R-Studios/Rocky-Hockey-IV/VortragsMedien/Images/ImageDebuggingWindow/MedianBlur.png

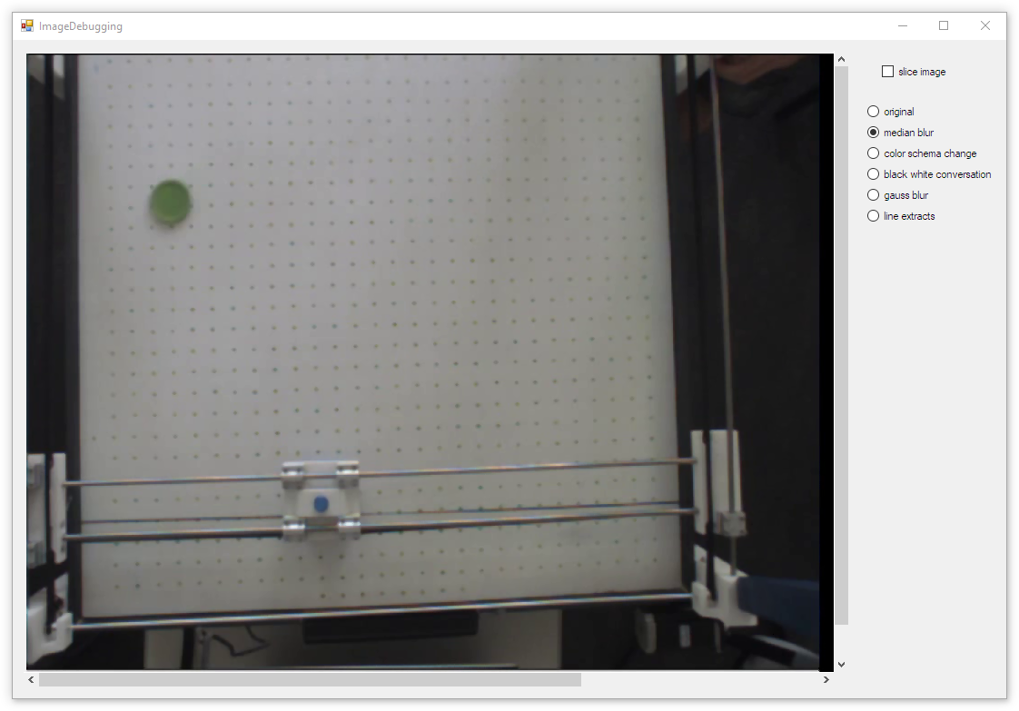
VortragsMedien/Images/ImageDebuggingWindow/MedianBlur.png
