R-Studios/Rocky-Hockey-IV/VortragsMedien/Images/ImageDebuggingWindow/ChangedColorSchema.png

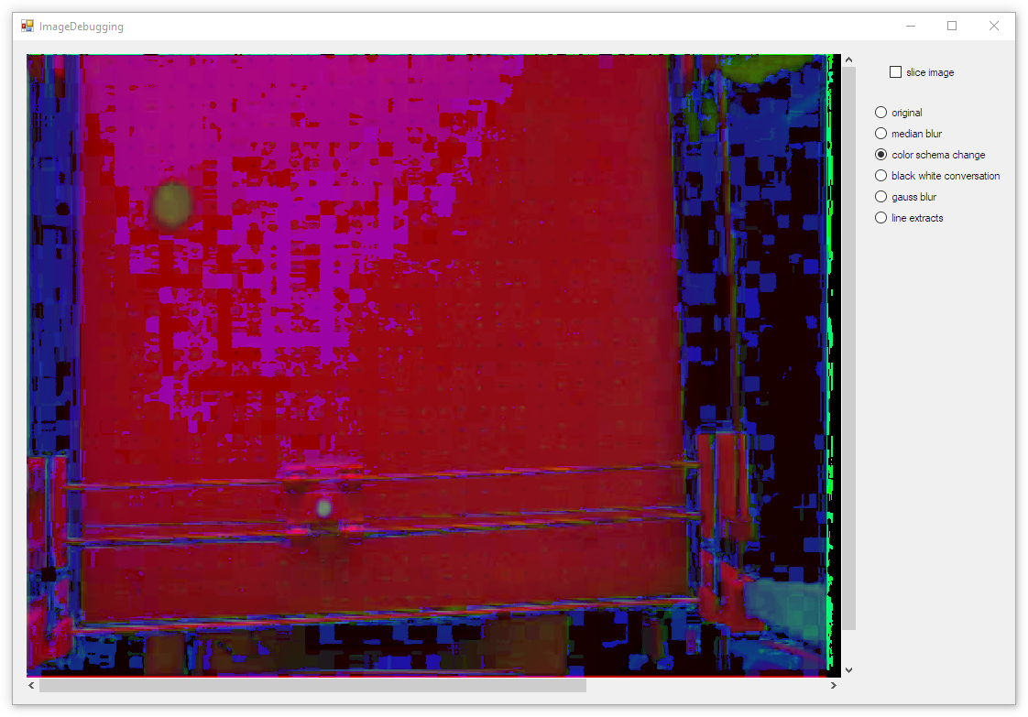
VortragsMedien/Images/ImageDebuggingWindow/ChangedColorSchema.png
