R-Studios/Rocky-Hockey-IV/Berichte/Rocky Hockey IV Bericht 12.pdf

# Rocky Hockey IV

Bericht über Woche 12
Zeitraum: 8.06.2020 – 14.06.2020 Teamleiter: Thomas Brücklmayr Berichterstatter: Thomas Brücklmayr

Rückblick auf die letzte Woche:
Thomas G. hat die Zwischenplatte überarbeitet, erneuter Funktionstest steht noch an. 12.06.: André holt die Materiallieferung ab und deponiert diese im Raum. Alex überprüft das Material anschließend noch.

Wegen Seminararbeiten diverser Gruppenmitglieder hat sich anderweitig kein Fortschritt ergeben.

Ausblick auf die nächste Woche:
Arbeit am digitalen Tisch starten. Neue Hardware einbauen.
