R-Studios/Rocky-Hockey-IV/Berichte/Rocky Hockey IV Bericht 15.pdf

# Rocky Hockey IV

Bericht über Woche 15
Zeitraum: 28.06.2020 – 03.07.2020 Teamleiter: Thomas Brücklmayr Berichterstatter: Alexander Fichtl

Rückblick auf die letzte Woche:
Thomas B., Alexander, Roman, David, Marco, und Domi trafen sich am Dienstag den 30.06. und führten einen Integrationstest der neuen Kameramodule durch. Leider traten durchgehend Fehler auf, für die es keine Dokumentation von ArduCam gibt. Nach einigen Stunden hatten wir aber endlich ein Bild in einem Visual Studio Projekt auf Romans Rechner. Uns wurde jedoch klar, dass wir durch die sehr späte Lieferung der Kamera Module voraussichtlich die Integration bis zur Projektvorstellung nicht abschließen können. Daher arbeiten wir nun parallel wieder mit der PS3 Kamera. Thomas B. hat dabei jeweils ein Fenster erstellt, welches die Verarbeitungsstufen des Eingangsbildes darstellen kann und eines, mit welchem sich die Entzerrung des Bildes einstellen lässt.
Ein zweites Treffen von Thomas B., Alexander, und Roman gab es am Donnerstag den 02.07.. Es wurde erneut versucht die neue Kamera zu integrieren, was jedoch wieder scheiterte. Wir entschieden uns noch auf zusätzlichen Wegen mit dem Support Team Kontakt aufzunehmen, wobei wir jedoch bis heute weiterhin keine Antwort erhalten haben. Da wir nun Bescheid kamen, dass bereits am 07.07. die Präsentation des Projektes ansteht, fokussierten wir uns auf die Arbeit mit der alten Kamera. Thomas B. hat dabei ein weiteres Fenster erstellt, mit welchen man die Parameter für die Puckerkennung einstellen kann. Dafür wurde auch die Bildverarbeitungsklasse überarbeitet und eine Klasse erstellt, mit der man von einem Video aus Bilder einlesen kann (so muss man den Code nicht immer im Raum testen, sondern auch von zuhause aus). Des Weiteren erstellte Alexander ein Layout für den Abschlussbericht und setzte diesen auf.
Das gesamte Team traf sich dann am Freitag den 03.07. (auch im Projektraum) und besprach das Vorgehen bei der anstehenden Präsentation und Poster Session. Es wurden Videos aufgenommen, die zusammengeschnitten auf Zoom gezeigt werden sollen.

Ausblick auf die nächste Woche:
Bis Dienstag muss das Video für die Präsentation geschnitten und die Poster Session vorbereitet werden.
Der Abschlussbericht muss geschrieben werden, so dass dieser in der folgenden, letzten Woche finalisiert werden kann. Alexander wird dies koordinieren.
Es gibt noch einige Baustellen im Code, die bearbeitet werden müssen.
Sollten wir endliche eine Antwort des ArduCam Supports erhalten, können wir eventuell auch noch weiter mit der neuen Kamera arbeiten.
