R-Studios/Rocky-Hockey-IV/Berichte/Rocky Hockey IV Bericht 16.docx

Rocky Hockey IV

Bericht über Woche 16

Zeitraum: 04.07.2020 – 10.07.2020

Teamleiter: Thomas Brücklmayr

Berichterstatter: Alexander Fichtl

Rückblick auf die letzte Woche:

Es wurde entschieden, dass Thomas B., Alexander, Roman und Andre gemeinsam die Projekt Präsentation und Poster Sessions halten. Thomas B. und Roman kümmerten sich über das Wochenende hinweg um das Erstellen der Präsentation und einer Slide Show für die Poster Session.

Beides wurde am Montag bei zwei Test Zoom Sessions von Thomas B., Alexander und Roman finalisiert, leider gab es einen Hardwarefehler bei einem der Schrittmotoren, weshalb eine live Demo kurz vor knapp aus dem Plan gestrichen werden musste. Zum Glück gab es aber Aufnahmen von dem funktionierenden Tisch, welche wir in die Präsentation einfügen konnten. Andre hat außerdem noch ein Problem mit der Score-Zählung an der Java GUI gefixt.

Am Dienstag traf sich das selbige Präsentationsteam um 13:30 Uhr im Raum und bereitete die offiziellen Zoom Sessions vor. Außerdem montierten Sie das neue, von Sarah gebaute Gerüst und befestigten die Kamera. Anschließend hielten sie die Präsentation. Zur Poster Session konnten sie die Slide Show über Zoom übertragen und per WebCam den AirHockey Tisch vorstellen.

Über die Woche hinweg haben bereits einige Teammitglieder ihren Abschlussbericht Teil fertiggestellt.

Ausblick auf die nächste Woche:

Hier und da wird noch am Code gebastelt werden.

Der Bericht muss fertiggestellt werden. Dazu braucht es die Teile der übrigen Teammitglieder. Alexander wird anschließend das Layout korrigieren und nochmals anpassen.
