R-Studios/Rocky-Hockey-IV/Berichte/Rocky Hockey IV Bericht 13.pdf

### Rocky Hockey IV

Bericht über Woche 13

Zeitraum: 15.06.2020 – 21.06.2020

Teamleiter: Thomas Brücklmayr

Berichterstatter: Sarah Hörmann

Rückblick auf die letzte Woche:

David, Marco und Thomas B. haben sich mit der Strategie beschäftigt. Sie haben festgelegt, welche Klassen benötigt werden, um die Strategie zu berechnen. Außerdem haben sie ein Interface erstellt, damit die von David und Marco erstellten Klassen miteinander kommunizieren können.

Dominik hat die Steuerung und Oberfläche vom virtuellen Tisch erstellt. Die Simulation mit dem Puck funktioniert. Allerdings werden die Daten des Schlägers noch nicht analysiert und ausgewertet.

Thomas G. hat die Zwischenplatte vom Tisch angepasst, aber noch nicht angebracht.

Andre hat das System zum Hochheben der Platte angebracht und dabei noch kleinere Veränderungen vorgenommen.

Alex hat die neue Hardware erstmals angeschlossen und mit dessen Integration begonnen.

Ausblick auf nächste Woche:

Dominik wird die Bewegungsdaten des Schlägers vom virtuellen Tisch analysieren und verarbeiten.

Erster Versuch alle Module in Betrieb zu nehmen.
