R-Studios/Rocky-Hockey-IV/Berichte/Rocky Hockey IV Bericht 2.pdf

Rockey Hockey IV

Bericht über Woche 11

Zeitraum: 01.06.2020 - 07.06.2020

Teamleiter: Thomas Brücklmayr

Berichterstatter: André Fischer

Rückblick auf die letzte Woche:

Am Donnerstag war André am Tisch und hat einen Prototypen seines Systems angebracht, sodass man die Platte inzwischen alleine hochheben und wieder runterlassen kann um Tests zu vereinfachen. Das Eigentliche System wird eingebaut, nachdem die neue Platte fertig ist und von dieser die Masse genommen werden konnten.

Dabei wurde entschieden, dass Thomas sich um die Pfadvorhersage für den Puck kümmert, während david marco n beiden an den Strategien arbeiten. Momentan können noch nur per Code die Puckbewegungen simuliert werden

Ausblick auf die nächste Woche:

An einer Live-Vorschau der Kamera als richtiges Feature und einem virtuellen Tisch, an dem auch ohne den Tischaufbau getestet werden kann arbeiten Roman und Dominik. David und Marco implementieren die neuen Spielstrategien. Sarah beginnt mit dem Neubau der Halterung für die Kamera. Meiko startet damit, die Dokumentation zu schreiben.
