R-Studios/Rocky-Hockey-IV/Berichte/Rocky Hockey IV Bericht 11.pdf

# Rocky Hockey IV

Bericht über Woche 11

Zeitraum: 01.06.2020 – 07.06.2020

Teamleiter: Thomas Brücklmayr

Berichterstatter: Thomas Gantner

Rückblick auf die letzte Woche:

Dominik und Roman haben in der C# GUI die Fenster überarbeitet und haben eine Live Ansicht der aktuellen Kamera hinzugefügt. Sie zeigt später die Sicht der Kamera die oben am Tisch befestigt ist an.

Marco hat sich mit der Strategie beschäftigt, dort hat er festgestellt, dass die Strategie Bande bereits implementiert ist, ebenso hat er sich damit beschäftigt was passiert, wenn der Puck stehen bleibt.

André hat einen Prototyp angebracht, um die Platte hochzuheben. Jedoch war noch nicht sicher, ob wir eine neue Tischplatte bauen oder die alte weiterverwenden.

Meiko hat angefangen, die Dokumentation zu schreiben.

Sarah hat mit der Haltung für die Kamera angefangen, da die Kamera aber noch nicht da ist, hat sie noch nicht die Höhe der Kamera festgelegt.

Thomas G. hat die zwischenplatte angebracht, jedoch konnte hier noch keine Verbesserung des Luftstroms erzielt werden.

Ausblick auf nächste Woche:

Dominik und Thomas B. arbeiten an der Testumgebung, um Strategien testen zu können. Da die bestellten Teile vermutlich angekommen sind, werden diese nächste Woche getestet.
