R-Studios/Rocky-Hockey-IV/Berichte/Rocky Hockey IV Bericht 9.pdf

# Rocky Hockey IV

Bericht über Woche 9
Zeitraum: 18.04.2020 – 24.04.2020 Teamleiter: Thomas Brücklmayr Berichterstatter: Thomas Brücklmayr

Rückblick auf die letzte Woche:
22.05.: Sarah uns Meiko waren in der Hochschule und haben Maße vom Tisch genommen um das Kameragestell verbessern zu können. Meiko hat angefangen die Verkabelung des Tisches zu überarbeiten.

Sonstiges:
Die Zylinder für die Zwischenplatte sind angekommen und Thomas G. hat diese fertiggestellt, sie muss aber noch montiert werden.
Roman hat einen Ordner auf Github erstellt, in dem die Wochenberichte abgelegt werden sollen. André hat am Abschlussbericht weiter gearbeitet.
Bei der Strategieüberarbeitung und beim Testframework gibt es kein Update, da einige Mitglieder ihre Seminararbeiten halten mussten.

Ausblick auf die nächste Woche:
Arbeit an der Strategieüberarbeitung und dem Testframework starten.
