R-Studios/Rocky-Hockey-IV/Rockey_HockeyFotos_31.03.2020/00d87915-95fa-47ff-bbc2-8fb40d2df74e.jpg

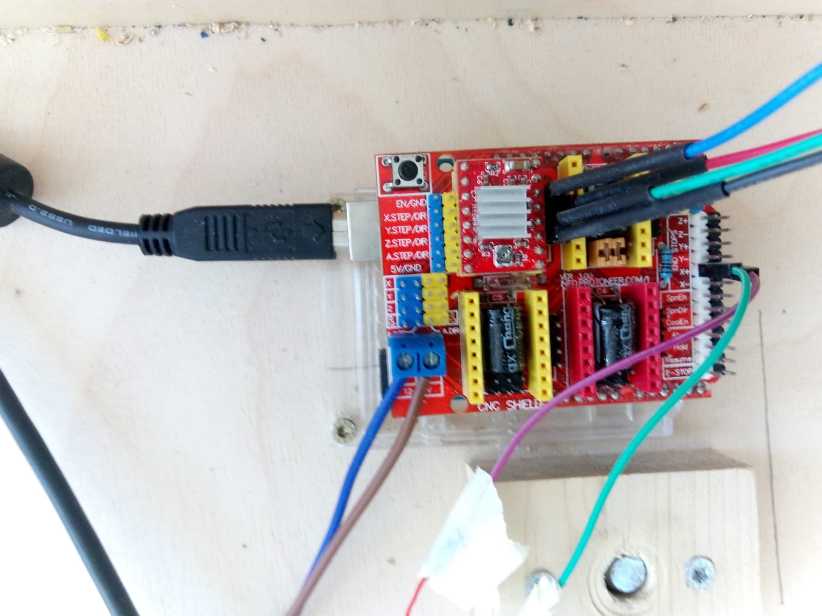
Rockey_HockeyFotos_31.03.2020/00d87915-95fa-47ff-bbc2-8fb40d2df74e.jpg
