R-Studios/Rocky-Hockey-IV/Rockey_HockeyFotos_31.03.2020/1ca494bc-8e8f-4f74-8567-929466d0e2ab.jpg

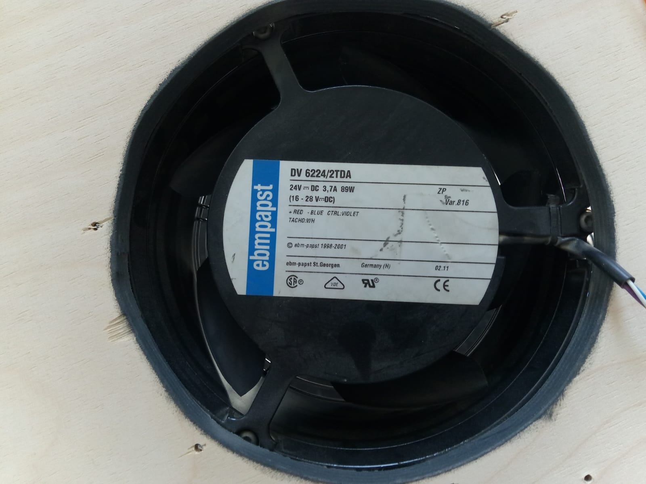
Rockey_HockeyFotos_31.03.2020/1ca494bc-8e8f-4f74-8567-929466d0e2ab.jpg
