R-Studios/Rocky-Hockey-IV/Rockey_HockeyFotos_31.03.2020/2cf4339c-4cba-40d5-88b1-021bc957ed77.jpg

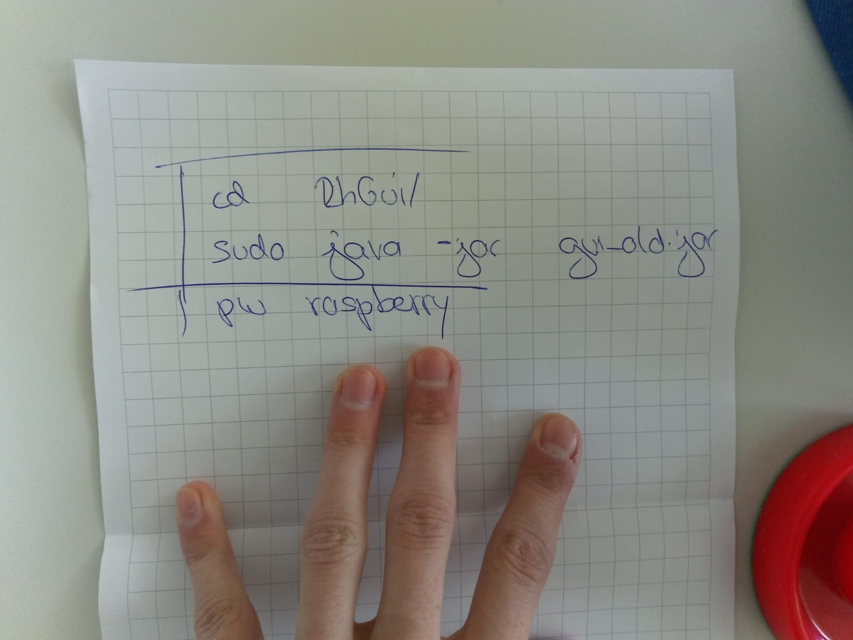
Rockey_HockeyFotos_31.03.2020/2cf4339c-4cba-40d5-88b1-021bc957ed77.jpg
