R-Studios/Rocky-Hockey-IV/Rockey_HockeyFotos_31.03.2020/03ef454f-9ccb-4f13-a578-67a4f2153c90.jpg

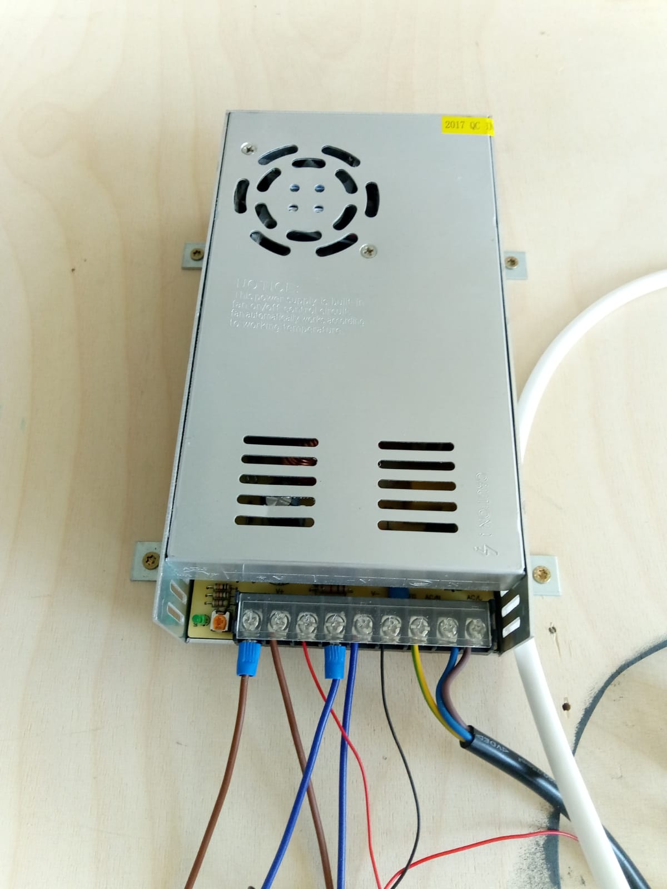
Rockey_HockeyFotos_31.03.2020/03ef454f-9ccb-4f13-a578-67a4f2153c90.jpg
