R-Studios/Rocky-Hockey-IV/Rockey_HockeyFotos_31.03.2020/5d71155f-a163-4400-9b1c-85306e660beb.jpg

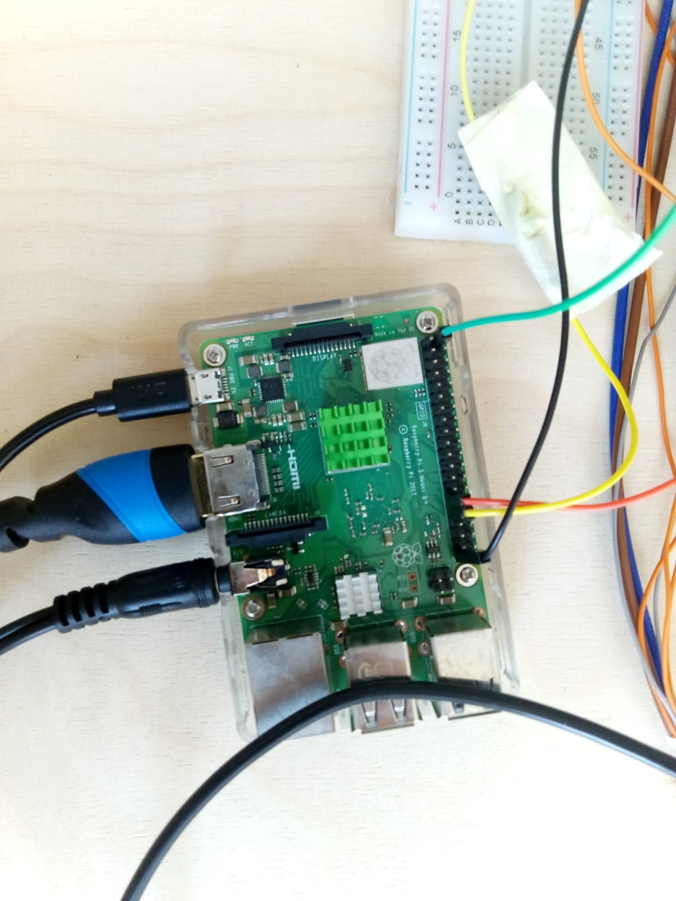
Rockey_HockeyFotos_31.03.2020/5d71155f-a163-4400-9b1c-85306e660beb.jpg
