R-Studios/Rocky-Hockey-IV/Rockey_HockeyFotos_31.03.2020/6ef581ab-93a6-46d1-a10a-12157c0630af.jpg

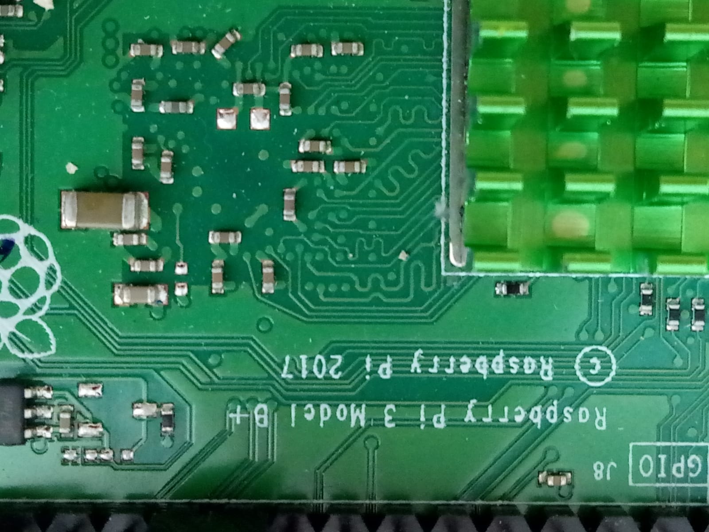
Rockey_HockeyFotos_31.03.2020/6ef581ab-93a6-46d1-a10a-12157c0630af.jpg
