R-Studios/Rocky-Hockey-IV/Rockey_HockeyFotos_31.03.2020/7f3fc055-a3bd-482a-82d1-738601f66e74.jpg

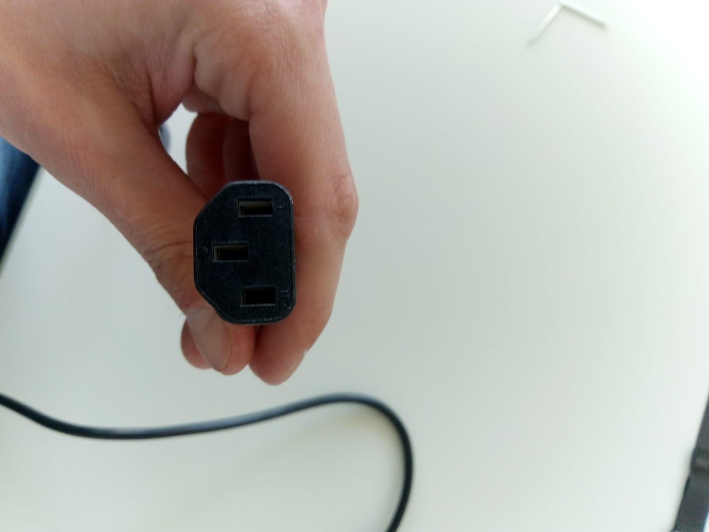
Rockey_HockeyFotos_31.03.2020/7f3fc055-a3bd-482a-82d1-738601f66e74.jpg
