R-Studios/Rocky-Hockey-IV/Rockey_HockeyFotos_31.03.2020/9b0b73de-4b14-485d-8741-7454e812c25b.jpg

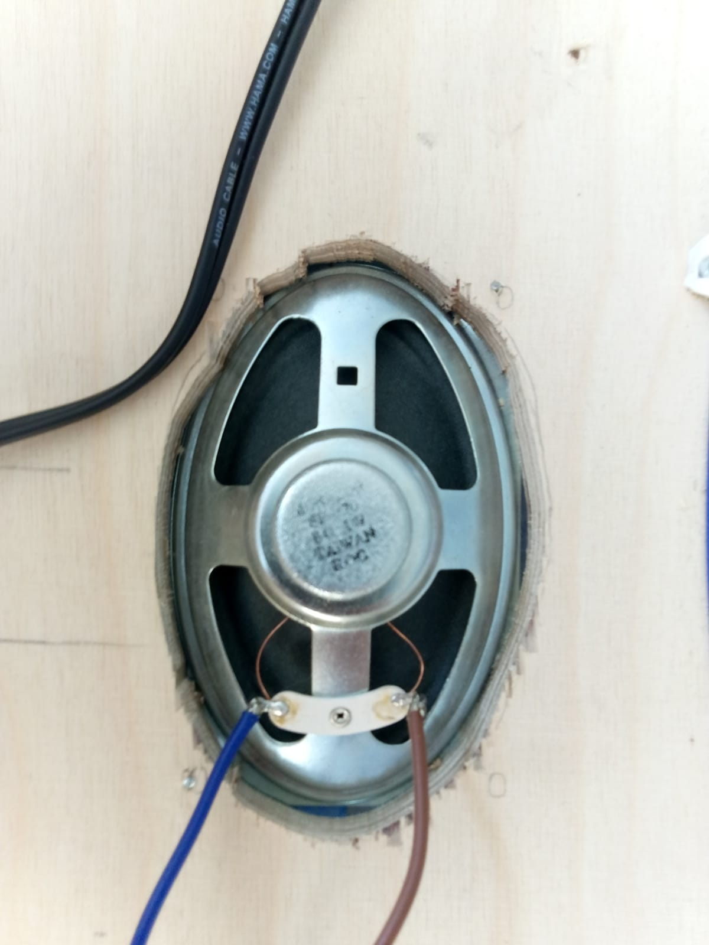
Rockey_HockeyFotos_31.03.2020/9b0b73de-4b14-485d-8741-7454e812c25b.jpg
