R-Studios/Rocky-Hockey-IV/Rockey_HockeyFotos_31.03.2020/21bee3ab-16a0-48f3-8c2e-569a640d96ab.jpg

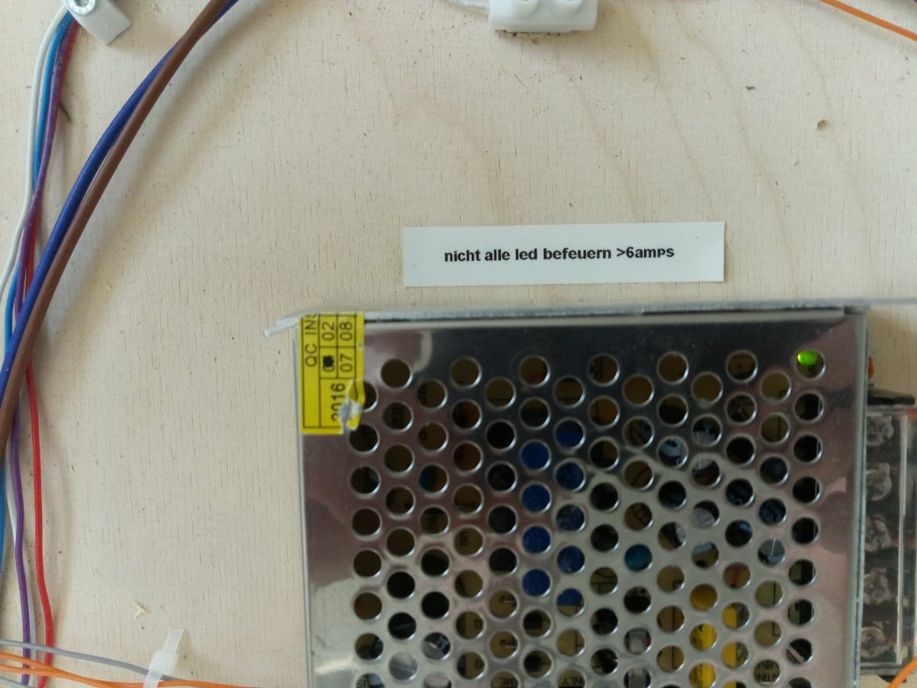
Rockey_HockeyFotos_31.03.2020/21bee3ab-16a0-48f3-8c2e-569a640d96ab.jpg
