R-Studios/Rocky-Hockey-IV/Rockey_HockeyFotos_31.03.2020/26e3dd24-239e-4486-86f7-c7c7a5132633.jpg

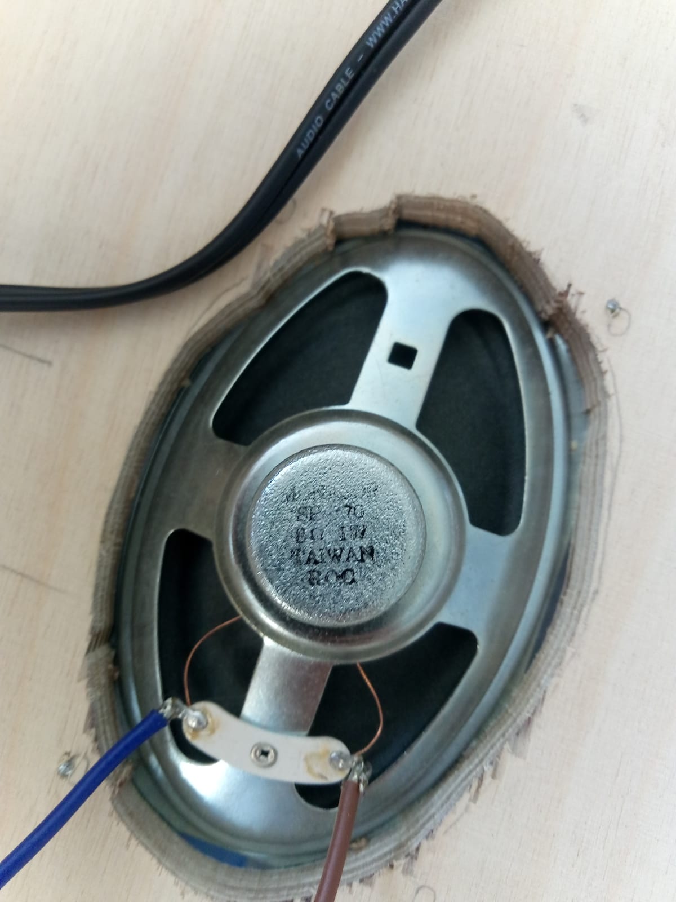
Rockey_HockeyFotos_31.03.2020/26e3dd24-239e-4486-86f7-c7c7a5132633.jpg
