R-Studios/Rocky-Hockey-IV/Rockey_HockeyFotos_31.03.2020/76b36d55-471f-48a3-a61c-02ed4cf30322.jpg

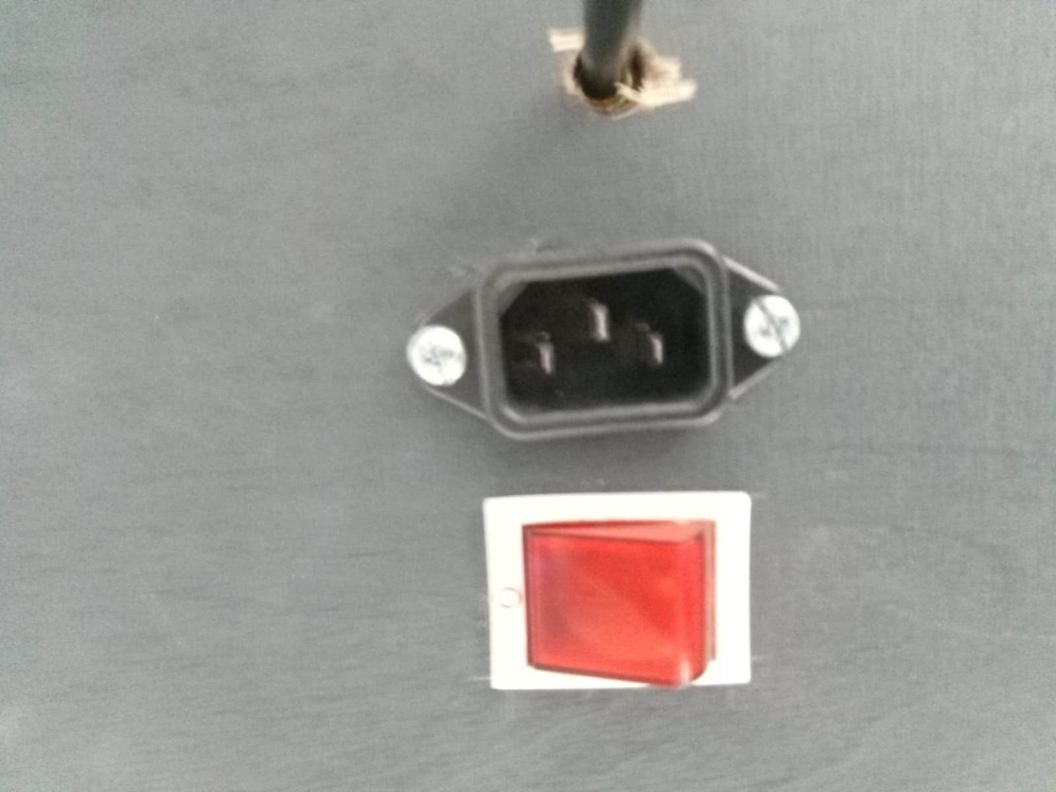
Rockey_HockeyFotos_31.03.2020/76b36d55-471f-48a3-a61c-02ed4cf30322.jpg
