R-Studios/Rocky-Hockey-IV/Rockey_HockeyFotos_31.03.2020/167ec176-c0d4-46ba-a58a-3f1380f40f1b.jpg

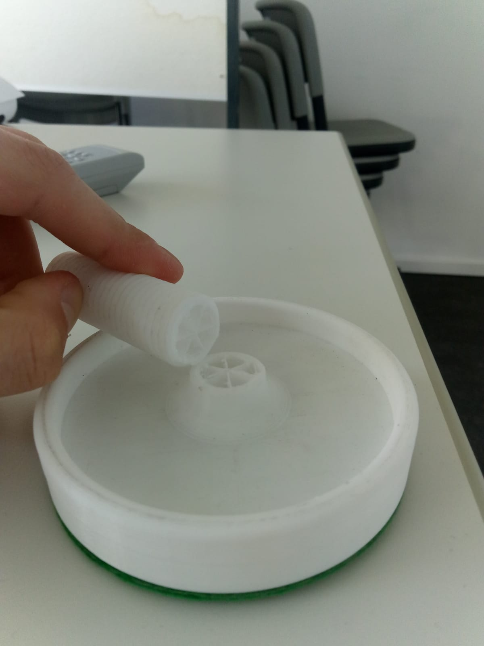
Rockey_HockeyFotos_31.03.2020/167ec176-c0d4-46ba-a58a-3f1380f40f1b.jpg
