R-Studios/Rocky-Hockey-IV/Rockey_HockeyFotos_31.03.2020/718ced31-0238-4f85-af24-9b75a0c0df73.jpg

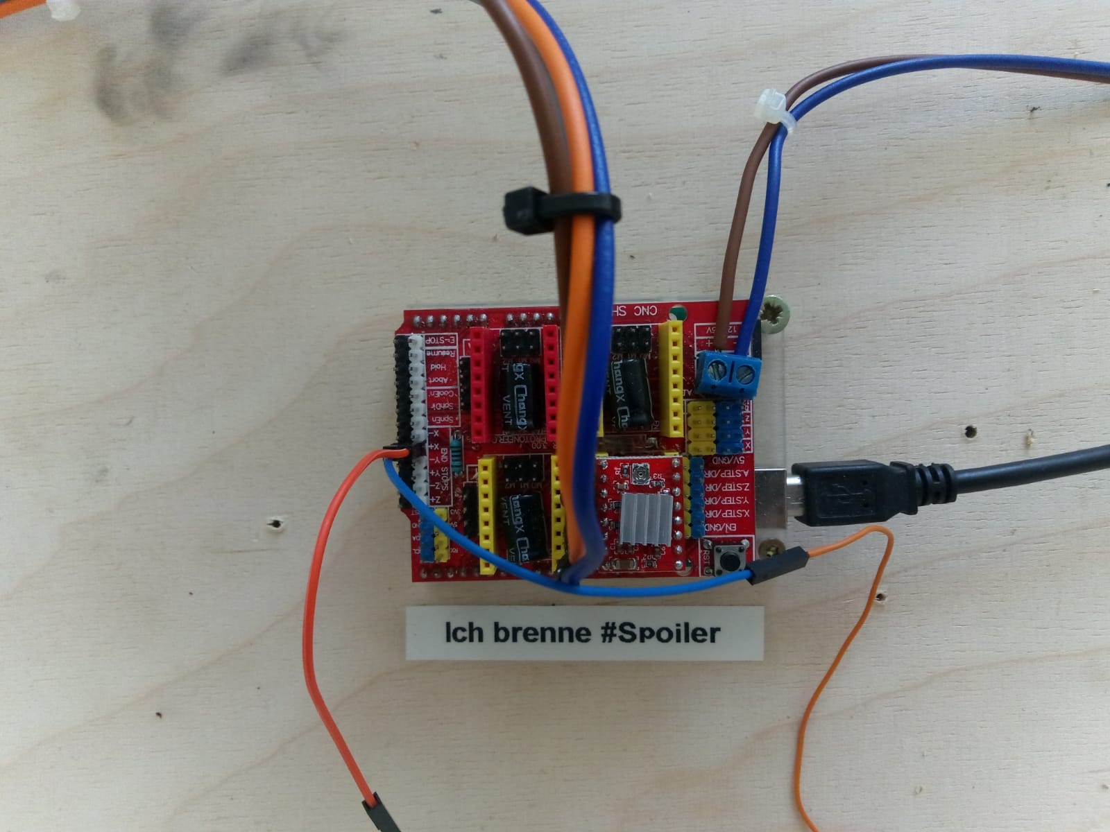
Rockey_HockeyFotos_31.03.2020/718ced31-0238-4f85-af24-9b75a0c0df73.jpg
