R-Studios/Rocky-Hockey-IV/Rockey_HockeyFotos_31.03.2020/73253075-4c92-4741-91b1-225926c06619.jpg

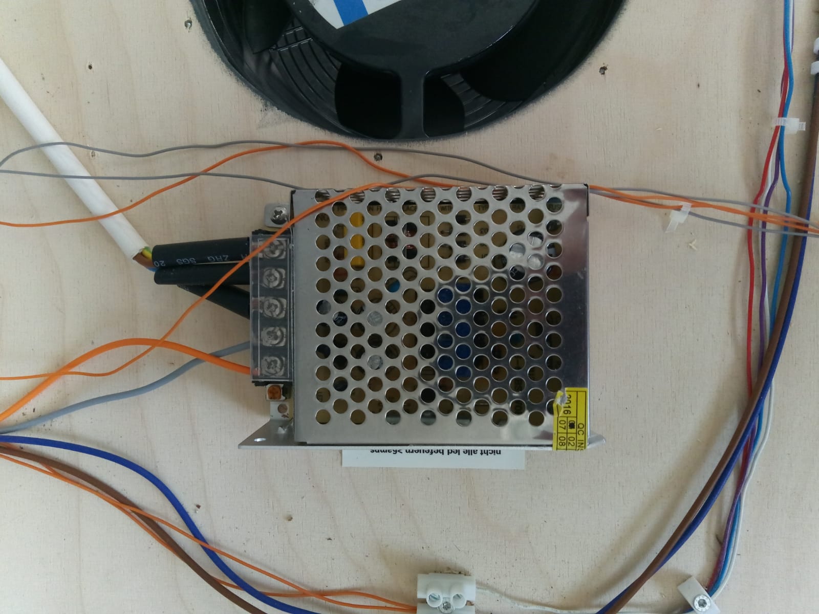
Rockey_HockeyFotos_31.03.2020/73253075-4c92-4741-91b1-225926c06619.jpg
