R-Studios/Rocky-Hockey-IV/Rockey_HockeyFotos_31.03.2020/a1b03794-e062-4586-b8a7-ea0471faf016.jpg

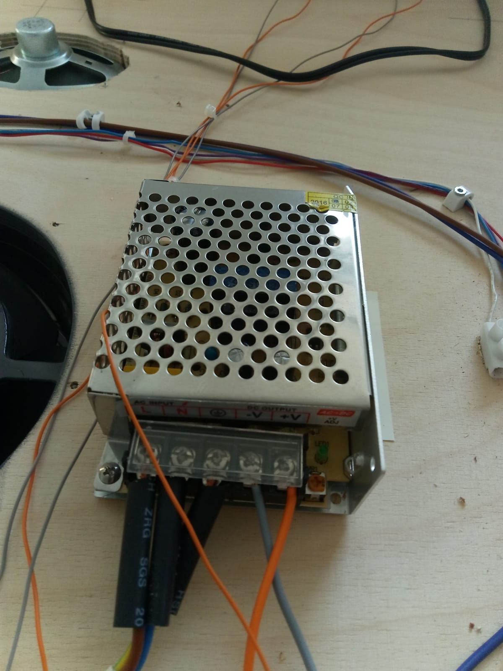
Rockey_HockeyFotos_31.03.2020/a1b03794-e062-4586-b8a7-ea0471faf016.jpg
