R-Studios/Rocky-Hockey-IV/Rockey_HockeyFotos_31.03.2020/cd410da4-7a8c-4a6b-875f-3e8eb30c133e.jpg

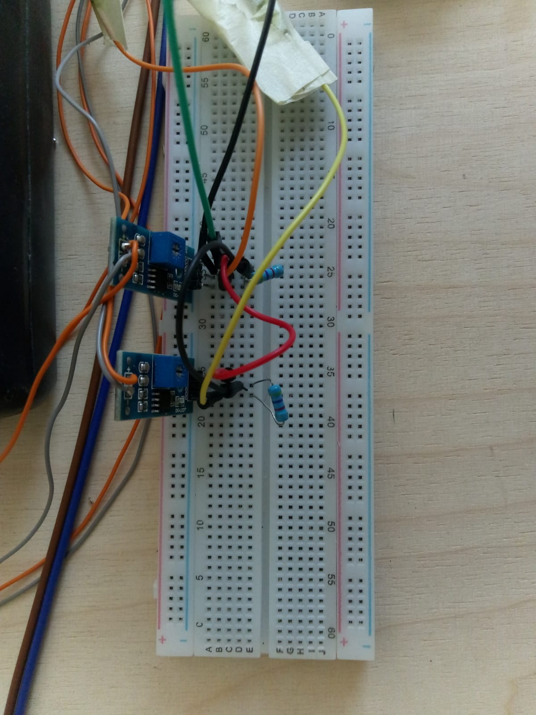
Rockey_HockeyFotos_31.03.2020/cd410da4-7a8c-4a6b-875f-3e8eb30c133e.jpg
