R-Studios/Rocky-Hockey-IV/Rockey_HockeyFotos_31.03.2020/eb7117b8-54d8-4a43-b824-05808e0c48bd.jpg

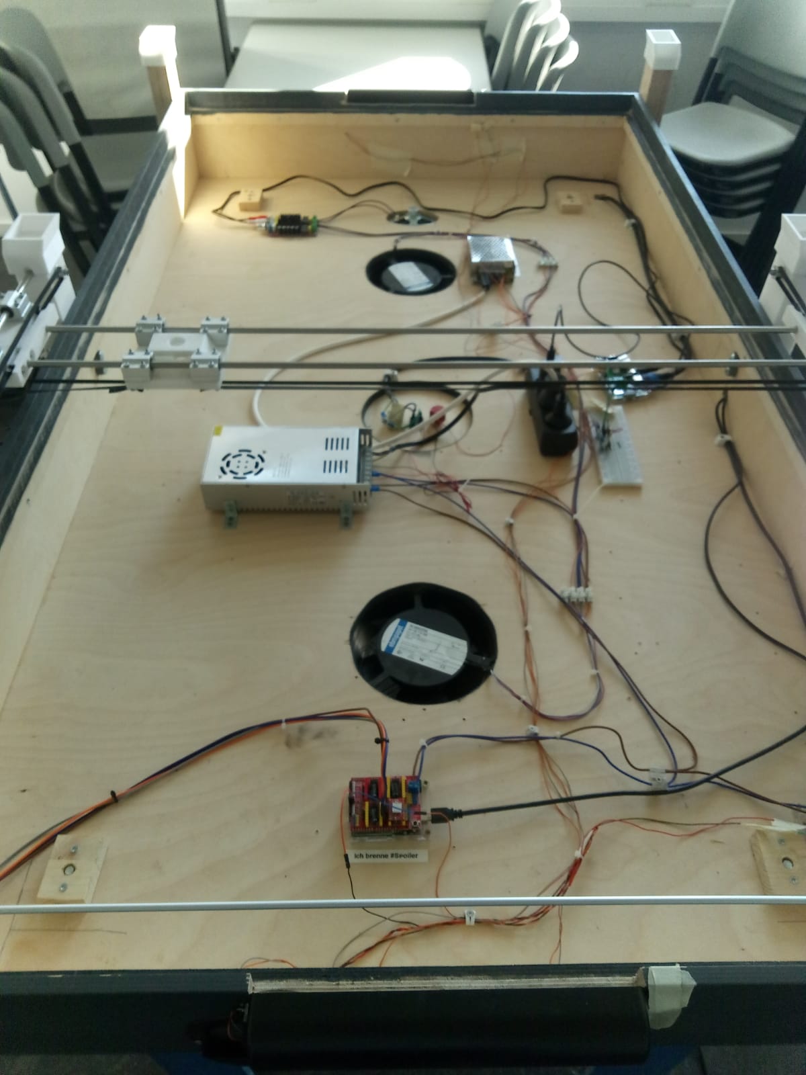
Rockey_HockeyFotos_31.03.2020/eb7117b8-54d8-4a43-b824-05808e0c48bd.jpg
