R-Studios/Rocky-Hockey-IV/Schaltplan/Schaltplan.jpg

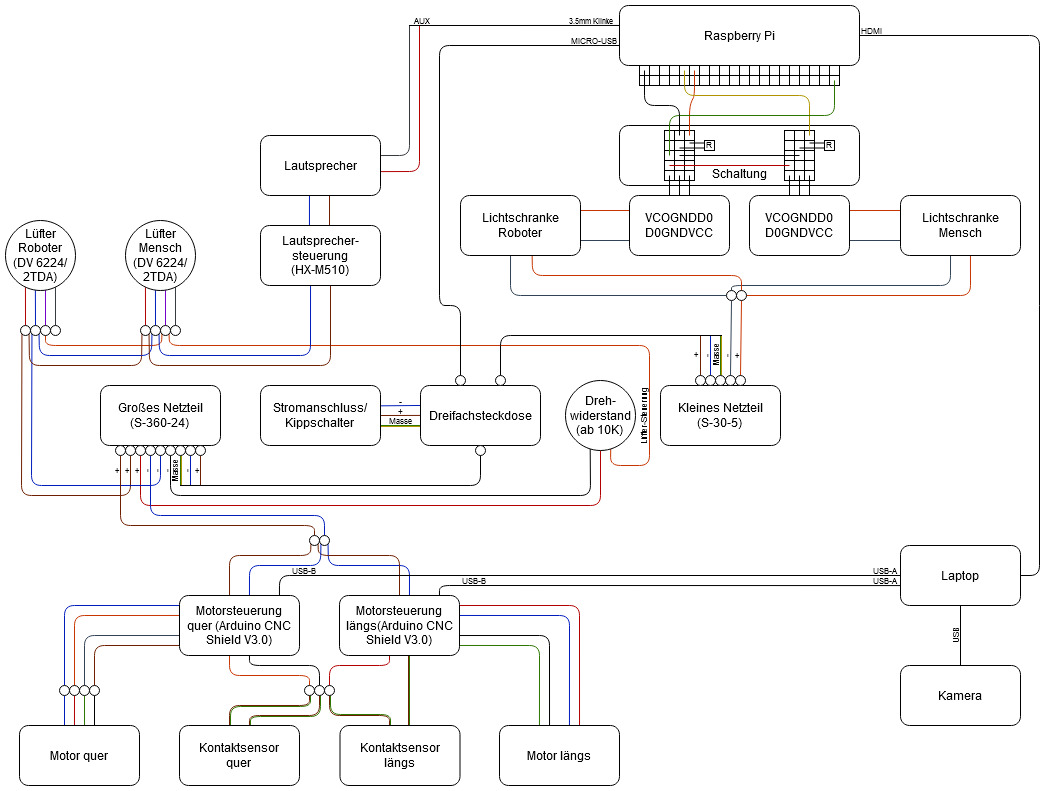
Schaltplan/Schaltplan.jpg
