R-Studios/Rocky-Hockey-IV/Schaltplan/Schaltplan_neu.jpg

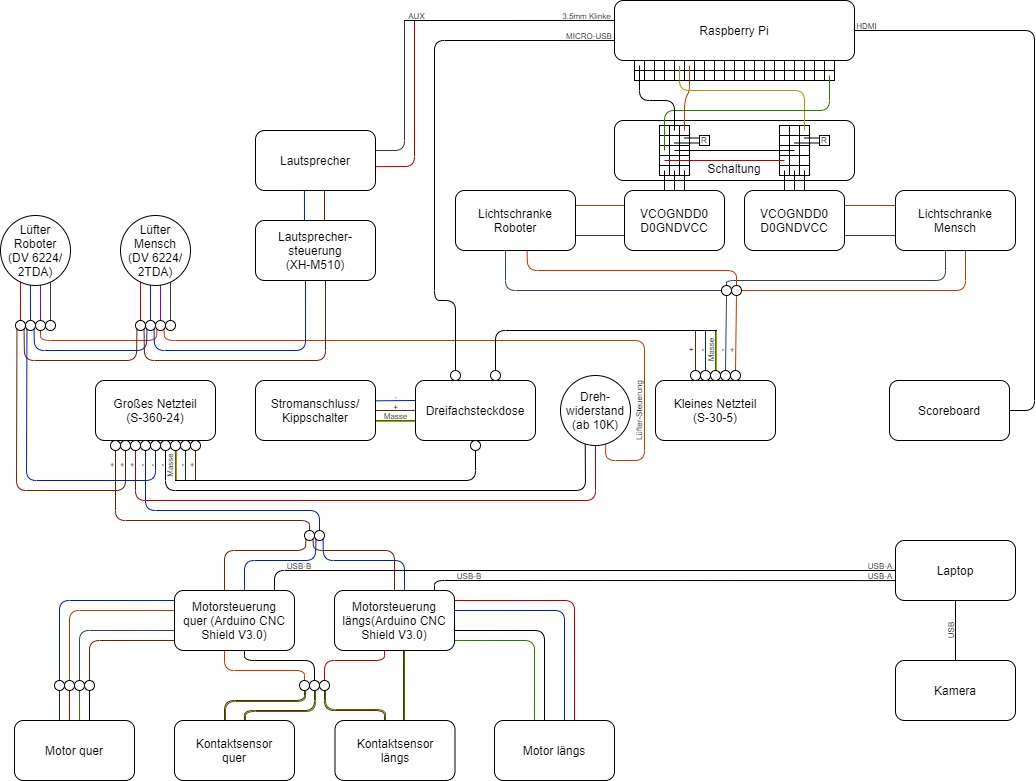
Schaltplan/Schaltplan_neu.jpg
