R-Studios/Rocky-Hockey-IV/STL Files/Überblick.PNG

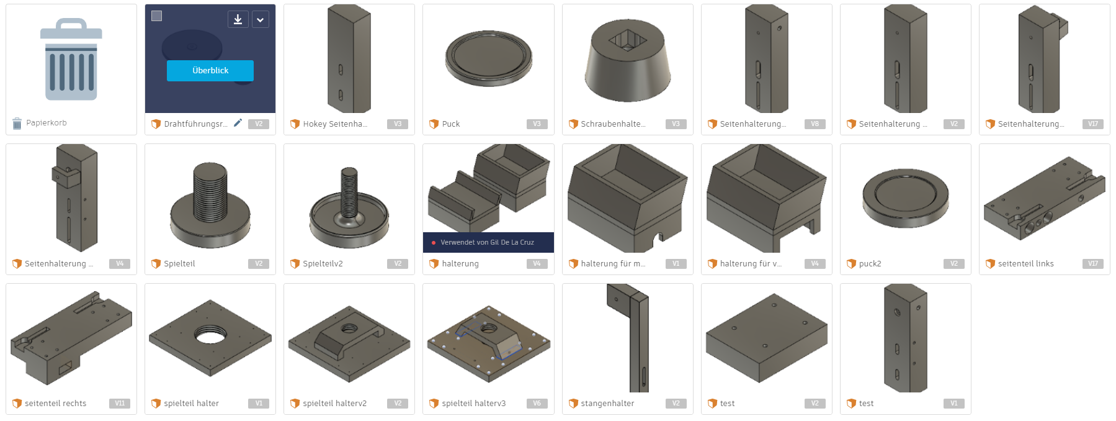
STL Files/Überblick.PNG
