R-Studios/Rocky-Hockey-IV/VortragsMedien/Images/CircleDetectionWindow/ImageAfterProcessing.png

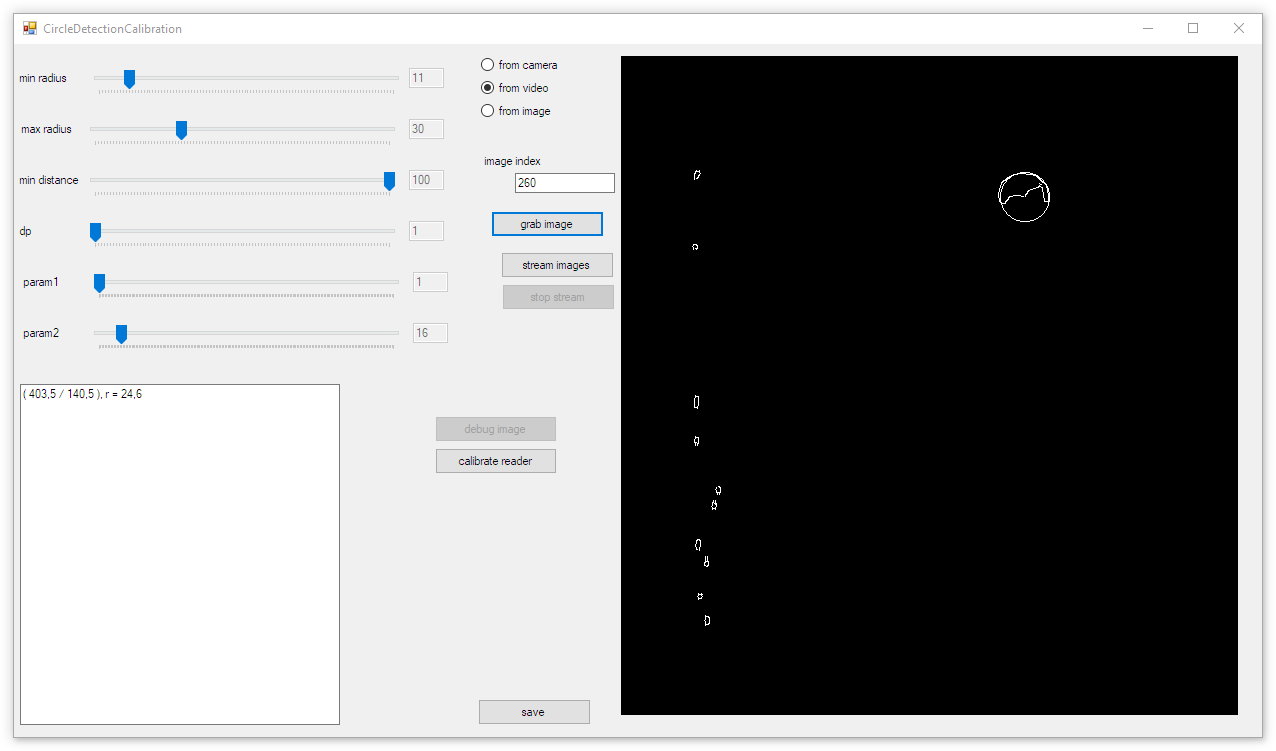
VortragsMedien/Images/CircleDetectionWindow/ImageAfterProcessing.png
