R-Studios/Rocky-Hockey-IV/VortragsMedien/Images/CircleDetectionWindow/OrignalImage.png

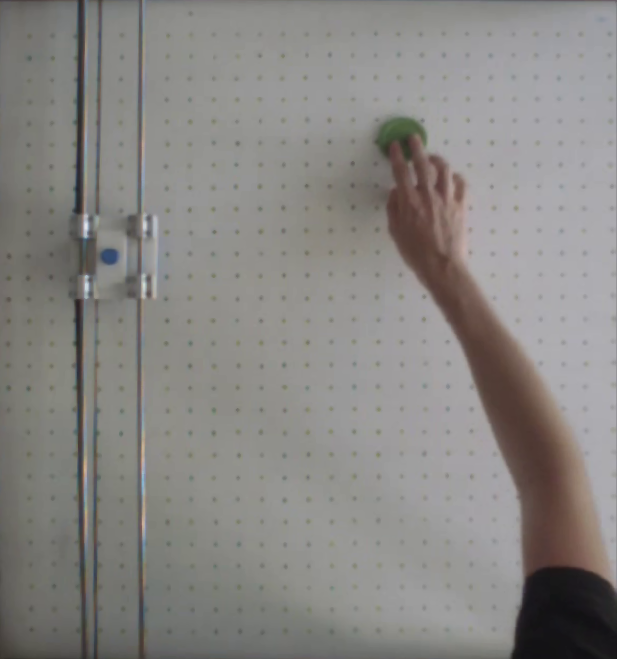
VortragsMedien/Images/CircleDetectionWindow/OrignalImage.png
