R-Studios/Rocky-Hockey-IV/VortragsMedien/Images/VirtualTable/Running.PNG

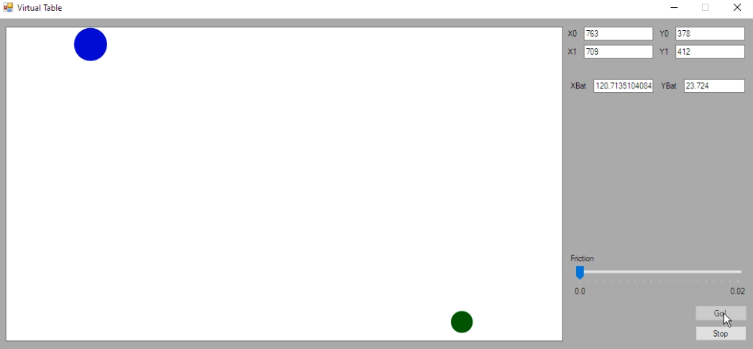
VortragsMedien/Images/VirtualTable/Running.PNG
