R-Studios/Rocky-Hockey-IV/VortragsMedien/Images/VirtualTable/StartAndDirectionSelection.PNG

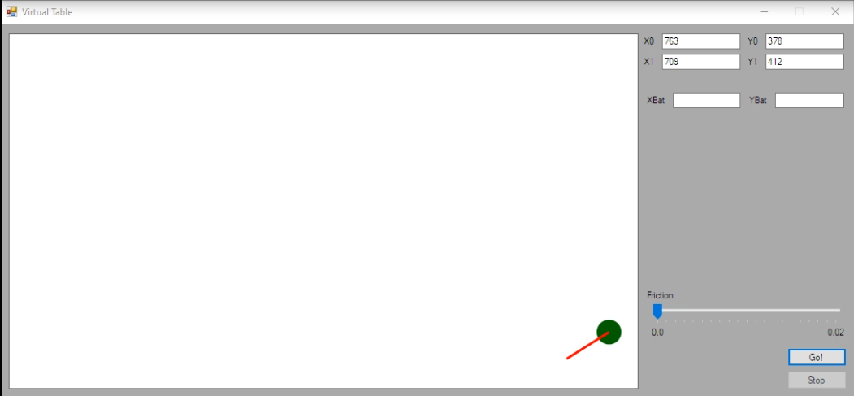
VortragsMedien/Images/VirtualTable/StartAndDirectionSelection.PNG
