R-Studios/Rocky-Hockey-IV/STL Files/Halterung für Mitte/halterung für mitte v1.step

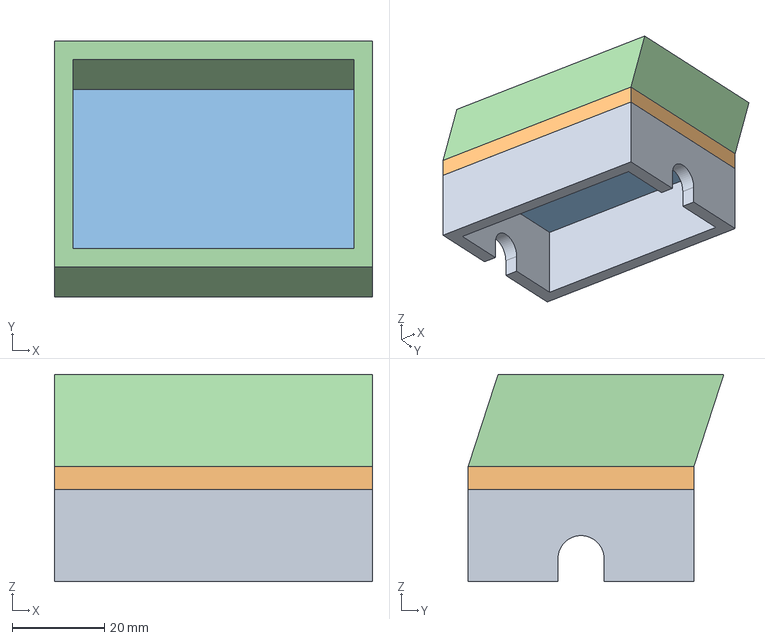
[picture p39: CAD file, 2020-07-12]
STL Files/Halterung für Mitte/halterung für mitte v1.step
69.0 x 55.5 x 45.0 mm
