R-Studios/Rocky-Hockey-IV/STL Files/Halterung/halterung v4.step

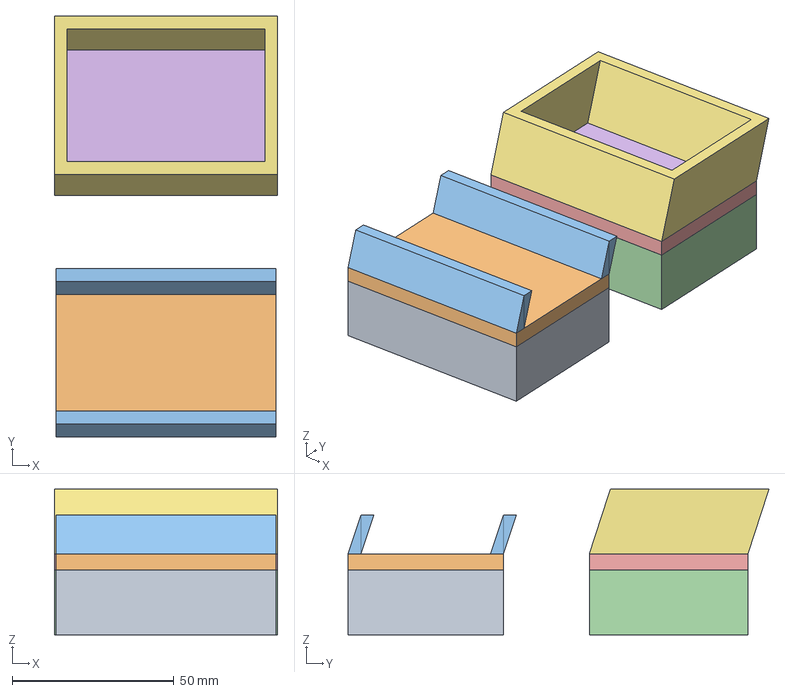
[picture p40: CAD file, 2020-07-12]
STL Files/Halterung/halterung v4.step
69.0 x 130.0 x 45.0 mm
