R-Studios/Rocky-Hockey-IV/STL Files/Hockey Seitenhalterung/Hokey Seitenhalterung v3.step

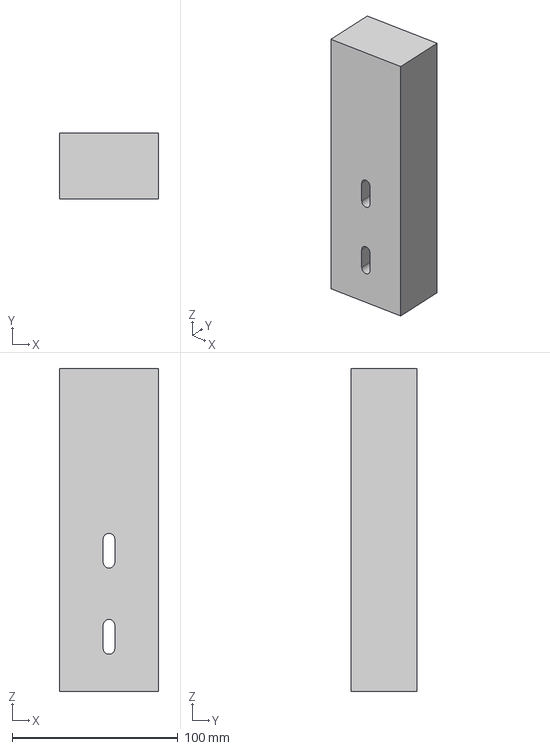
[picture p41: CAD file, 2020-07-12]
STL Files/Hockey Seitenhalterung/Hokey Seitenhalterung v3.step
60.0 x 40.0 x 195.0 mm
