R-Studios/Rocky-Hockey-IV/STL Files/Puck/Puck v3.step

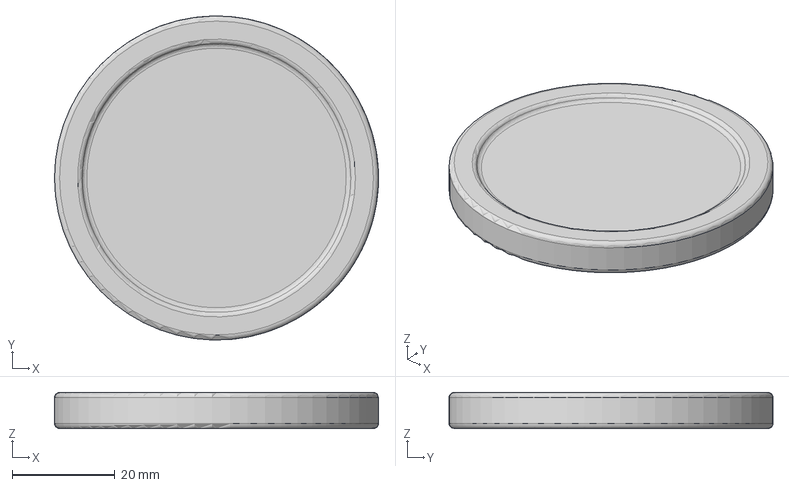
[picture p42: CAD file, 2020-07-12]
STL Files/Puck/Puck v3.step
63.0 x 63.0 x 7.00 mm
