R-Studios/Rocky-Hockey-IV/STL Files/Puck2/puck2 v2.step

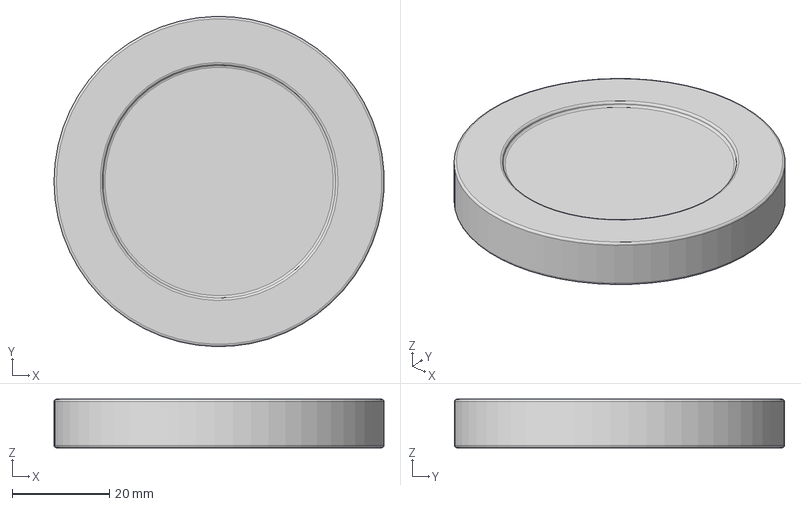
[picture p43: CAD file, 2020-07-12]
STL Files/Puck2/puck2 v2.step
67.9 x 68.0 x 10.0 mm
