R-Studios/Rocky-Hockey-IV/STL Files/Schraubenhalterung/Schraubenhalterung v3.step

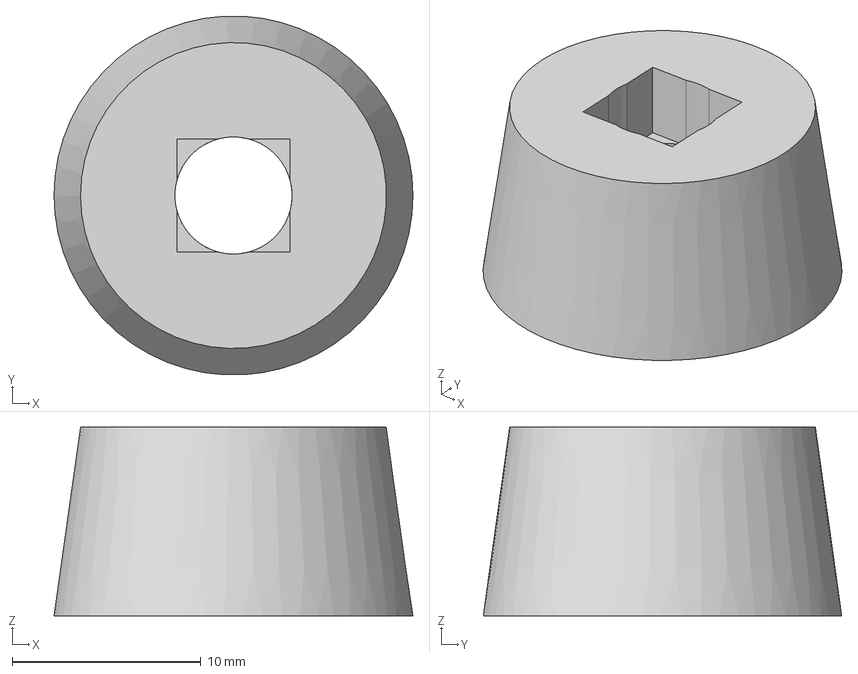
[picture p44: CAD file, 2020-07-12]
STL Files/Schraubenhalterung/Schraubenhalterung v3.step
19.0 x 19.0 x 10.0 mm
