R-Studios/Rocky-Hockey-IV/STL Files/Seitenhalterung für Mitte Links/Seitenhalterung für mitte links v8.step

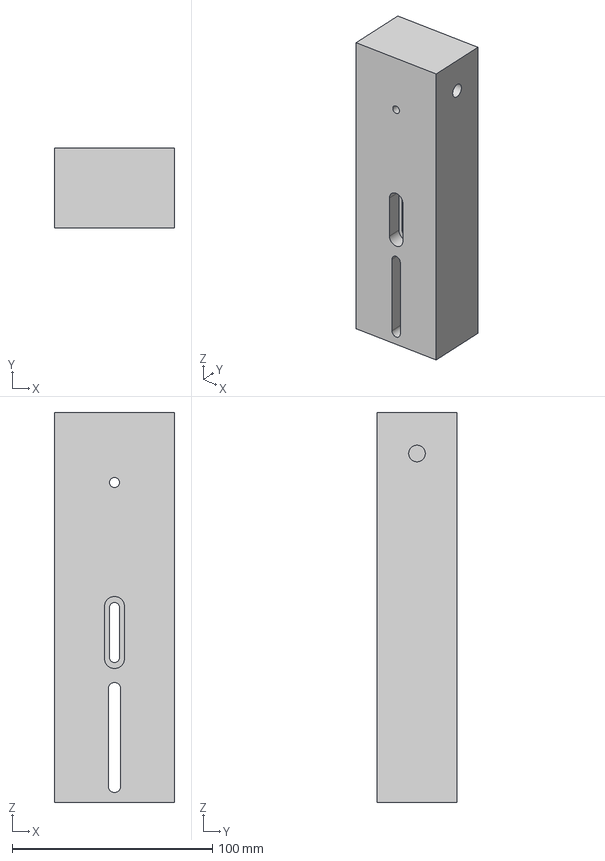
[picture p45: CAD file, 2020-07-12]
STL Files/Seitenhalterung für Mitte Links/Seitenhalterung für mitte links v8.step
60.0 x 40.0 x 195.0 mm
