R-Studios/Rocky-Hockey-IV/STL Files/Seitenhalterung für Vorne Links/Seitenhalterung für vorne links v17.step

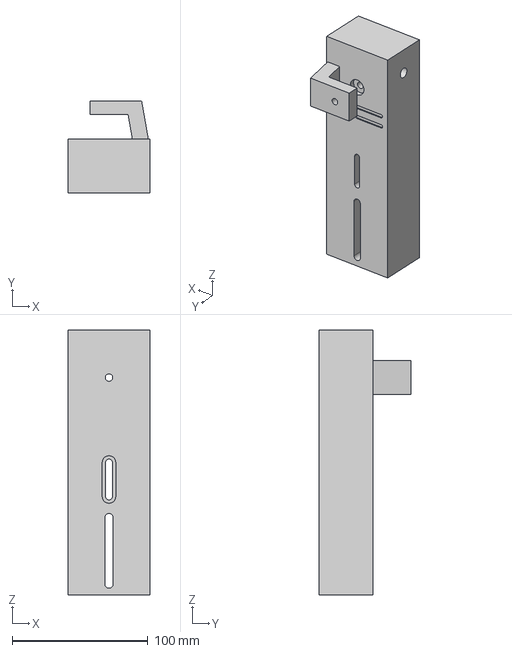
[picture p46: CAD file, 2020-07-12]
STL Files/Seitenhalterung für Vorne Links/Seitenhalterung für vorne links v17.step
60.0 x 68.0 x 195.0 mm
