R-Studios/Rocky-Hockey-IV/STL Files/Seitenhalterung für vorne rechts/Seitenhalterung für vorne rechts v4.step

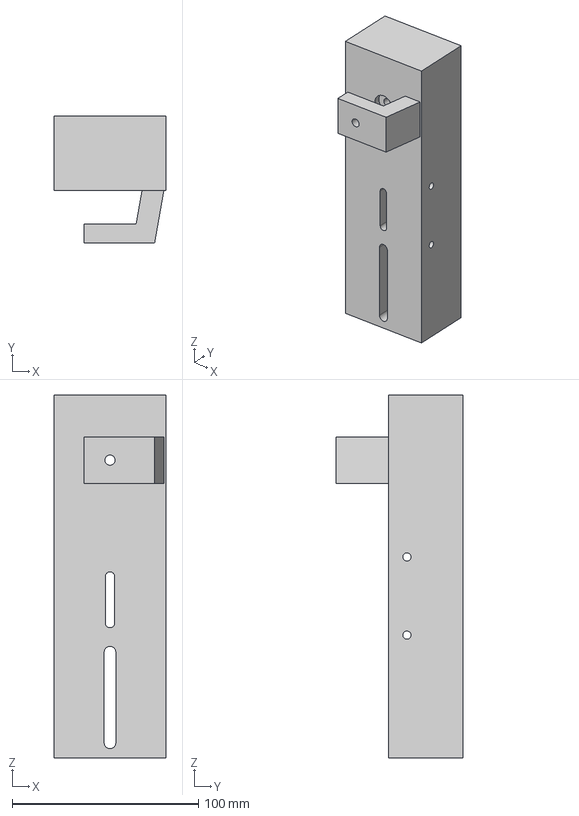
[picture p47: CAD file, 2020-07-12]
STL Files/Seitenhalterung für vorne rechts/Seitenhalterung für vorne rechts v4.step
60.0 x 68.0 x 195.0 mm
