R-Studios/Rocky-Hockey-IV/STL Files/Seitenteil Links/seitenteil links v17.step

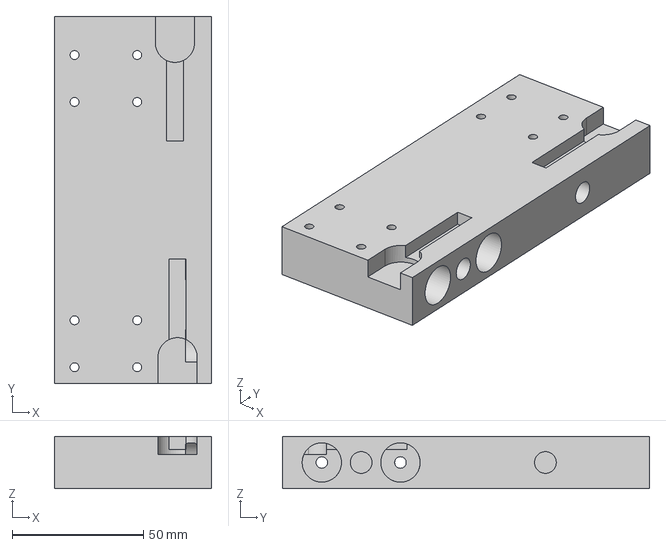
[picture p48: CAD file, 2020-07-12]
STL Files/Seitenteil Links/seitenteil links v17.step
60.0 x 140.0 x 20.0 mm
