R-Studios/Rocky-Hockey-IV/STL Files/Seitenteil Rechts/seitenteil rechts v11.step

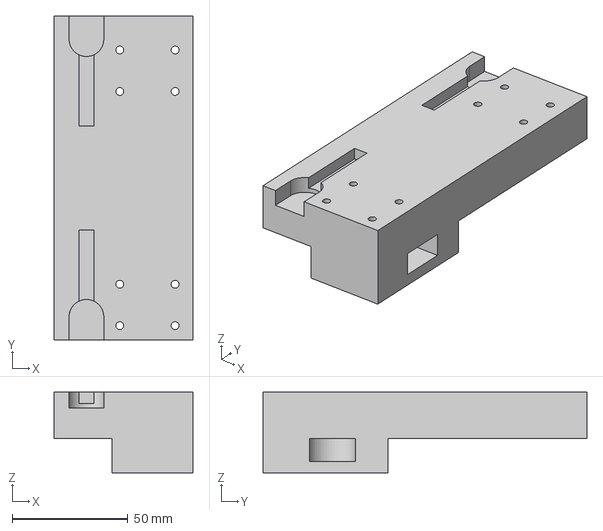
[picture p49: CAD file, 2020-07-12]
STL Files/Seitenteil Rechts/seitenteil rechts v11.step
60.0 x 140.0 x 35.0 mm
