R-Studios/Rocky-Hockey-IV/STL Files/Spielteil Halter/spielteil halter v1.step

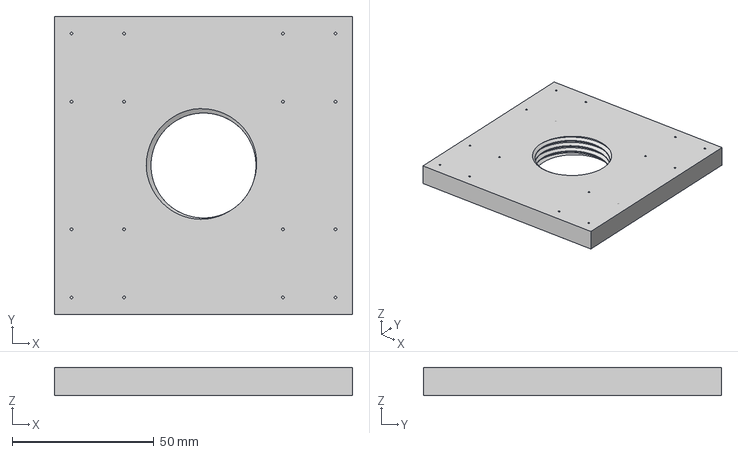
[picture p50: CAD file, 2020-07-12]
STL Files/Spielteil Halter/spielteil halter v1.step
105.0 x 105.0 x 10.0 mm
