R-Studios/Rocky-Hockey-IV/STL Files/Spielteil Halterv2/spielteil halterv2 v2.step

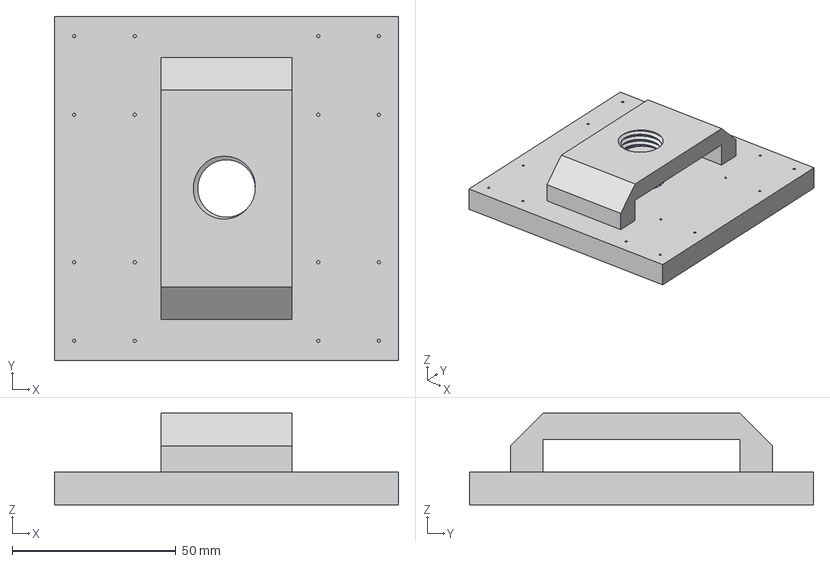
[picture p51: CAD file, 2020-07-12]
STL Files/Spielteil Halterv2/spielteil halterv2 v2.step
105.0 x 105.0 x 28.0 mm
