R-Studios/Rocky-Hockey-IV/STL Files/Spielteil/Spielteil v2.step

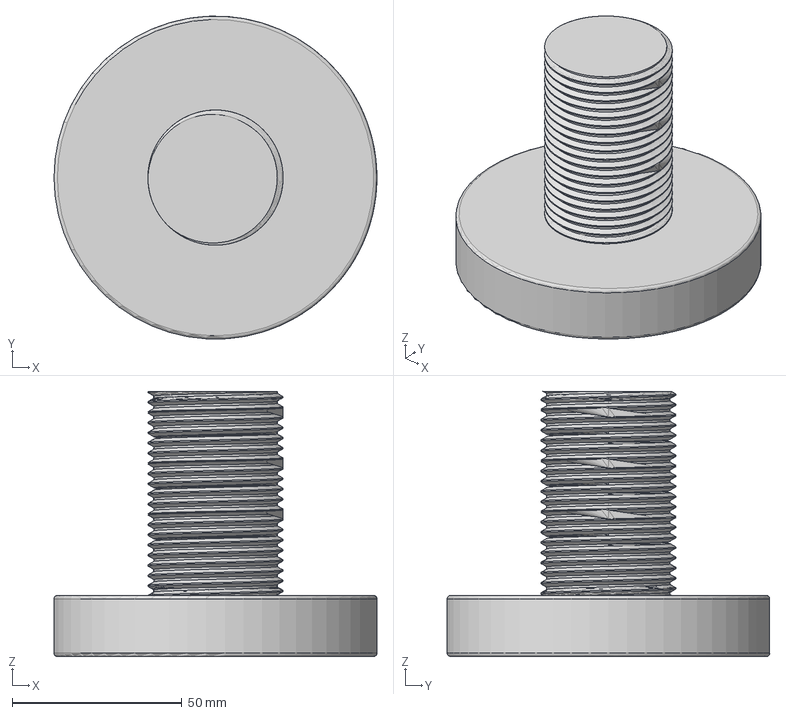
[picture p52: CAD file, 2020-07-12]
STL Files/Spielteil/Spielteil v2.step
95.0 x 94.9 x 78.0 mm
