R-Studios/Rocky-Hockey-IV/STL Files/Spielteilv2/Spielteilv2 v2.step

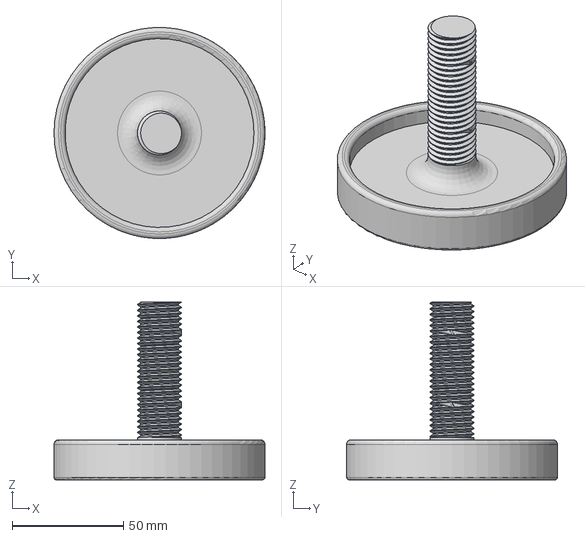
[picture p53: CAD file, 2020-07-12]
STL Files/Spielteilv2/Spielteilv2 v2.step
95.0 x 95.0 x 80.0 mm
