R-Studios/Rocky-Hockey-IV/STL Files/Test/test v1.step

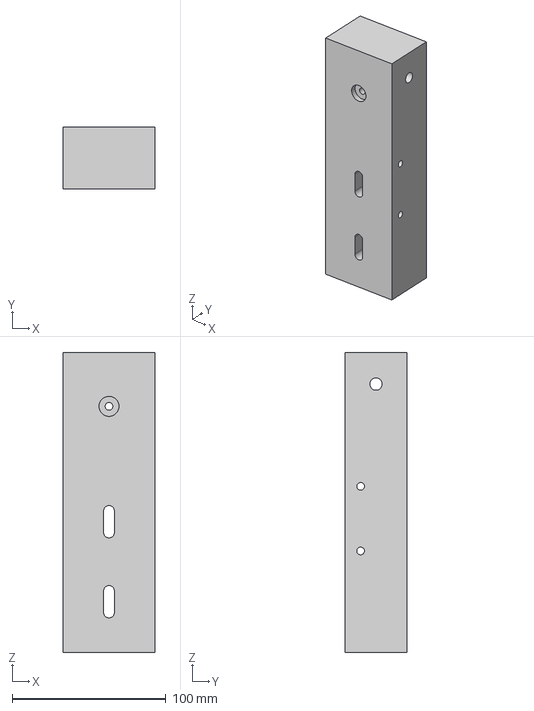
[picture p54: CAD file, 2020-07-12]
STL Files/Test/test v1.step
60.0 x 40.0 x 195.0 mm
