R-Studios/Rocky-Hockey-IV/(list of files, cad)

Other CAD files:
STL Files/Halterung für Vorne/halterung für vorne v4.step
STL Files/Seitenhalterung für Mitte rechts/Seitenhalterung für mitte rechts v2.step
STL Files/Spielteil Halterv3/spielteil halterv3 v6.step
STL Files/Halterung für Mitte/halterung für mitte v1.f3d
STL Files/Halterung für Mitte/halterung für mitte v1.stl
STL Files/Halterung für Vorne/halterung für vorne v4.f3d
STL Files/Halterung für Vorne/halterung für vorne v4.stl
STL Files/Halterung/halterung v4.f3d
STL Files/Halterung/halterung v4.stl
STL Files/Hockey Seitenhalterung/Hokey Seitenhalterung v3.f3d
STL Files/Hockey Seitenhalterung/Hokey Seitenhalterung v3.stl
STL Files/Puck/Puck v3.f3d
STL Files/Puck/Puck v3.stl
STL Files/Puck2/puck2 v2.f3d
STL Files/Puck2/puck2 v2.stl
STL Files/Schraubenhalterung/Schraubenhalterung v3.f3d
STL Files/Schraubenhalterung/Schraubenhalterung v3.stl
STL Files/Seitenhalterung für Mitte Links/Seitenhalterung für mitte links v8.f3d
STL Files/Seitenhalterung für Mitte Links/Seitenhalterung für mitte links v8.stl
STL Files/Seitenhalterung für Mitte rechts/Seitenhalterung für mitte rechts v2.f3d
STL Files/Seitenhalterung für Mitte rechts/Seitenhalterung für mitte rechts v2.stl
STL Files/Seitenhalterung für Vorne Links/Seitenhalterung für vorne links v17.f3d
STL Files/Seitenhalterung für Vorne Links/Seitenhalterung für vorne links v17.stl
STL Files/Seitenhalterung für vorne rechts/Seitenhalterung für vorne rechts v4.f3d
STL Files/Seitenhalterung für vorne rechts/Seitenhalterung für vorne rechts v4.stl
STL Files/Seitenteil Links/seitenteil links v17.f3d
STL Files/Seitenteil Links/seitenteil links v17.stl
STL Files/Seitenteil Rechts/seitenteil rechts v11.f3d
STL Files/Seitenteil Rechts/seitenteil rechts v11.stl
STL Files/Spielteil Halter/spielteil halter v1.f3d
STL Files/Spielteil Halter/spielteil halter v1.stl
STL Files/Spielteil Halterv2/spielteil halterv2 v2.f3d
STL Files/Spielteil Halterv2/spielteil halterv2 v2.stl
STL Files/Spielteil Halterv3/spielteil halterv3 v6.f3d
STL Files/Spielteil Halterv3/spielteil halterv3 v6.stl
STL Files/Spielteil/Spielteil v2.f3d
STL Files/Spielteil/Spielteil v2.stl
STL Files/Spielteilv2/Spielteilv2 v2.f3d
STL Files/Spielteilv2/Spielteilv2 v2.stl
STL Files/Test/test v1.f3d
STL Files/Test/test v1.stl
