R-Studios/Rocky-Hockey-IV/STL Files/Printsettings part 1.jpg

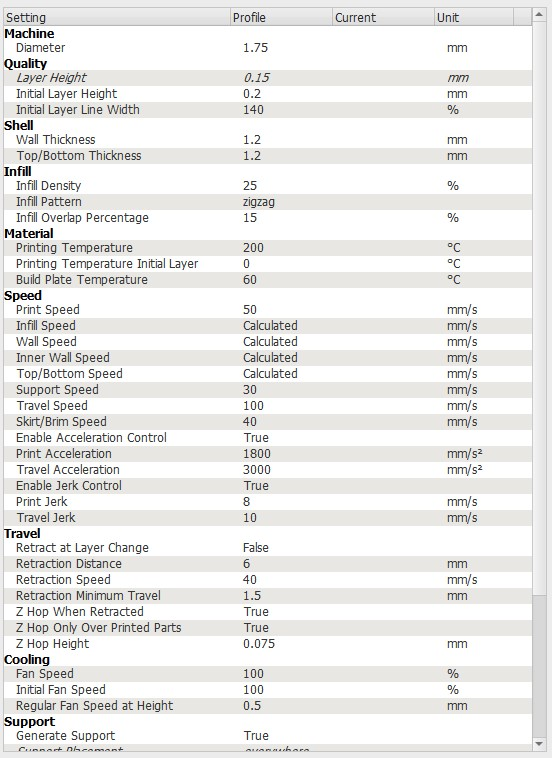
STL Files/Printsettings part 1.jpg
