R-Studios/Rocky-Hockey-IV/STL Files/Printsettings part 2.jpg

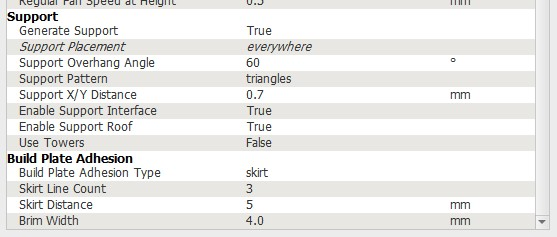
STL Files/Printsettings part 2.jpg
