R-Studios/Rocky-Hockey-IV/VortragsMedien/Images/CameraCalibrationWindow/FilledForm.png

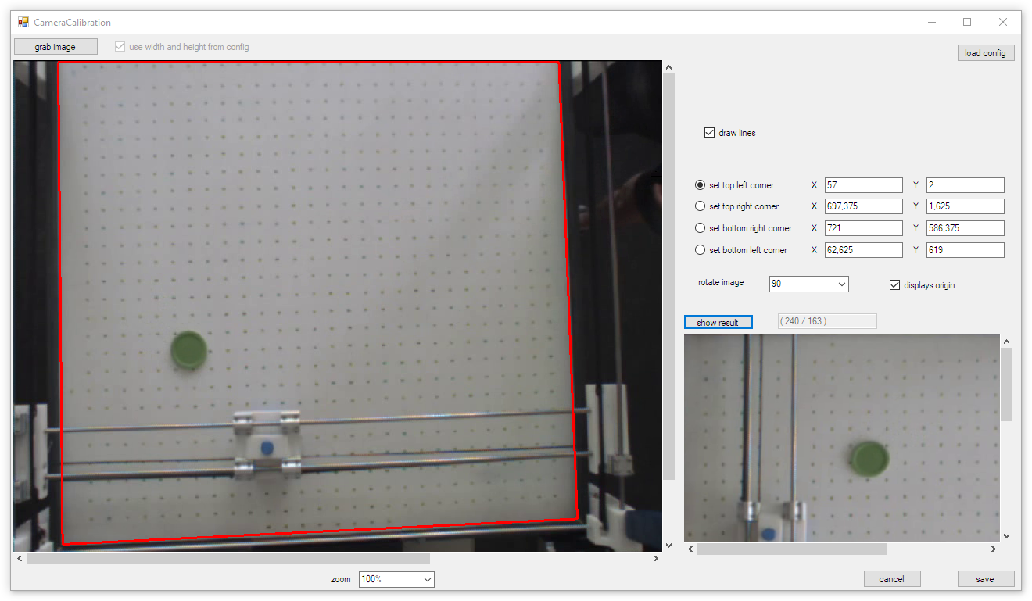
VortragsMedien/Images/CameraCalibrationWindow/FilledForm.png
