R-Studios/Rocky-Hockey-IV/VortragsMedien/Images/ImageDebuggingWindow/BlackWhite.png

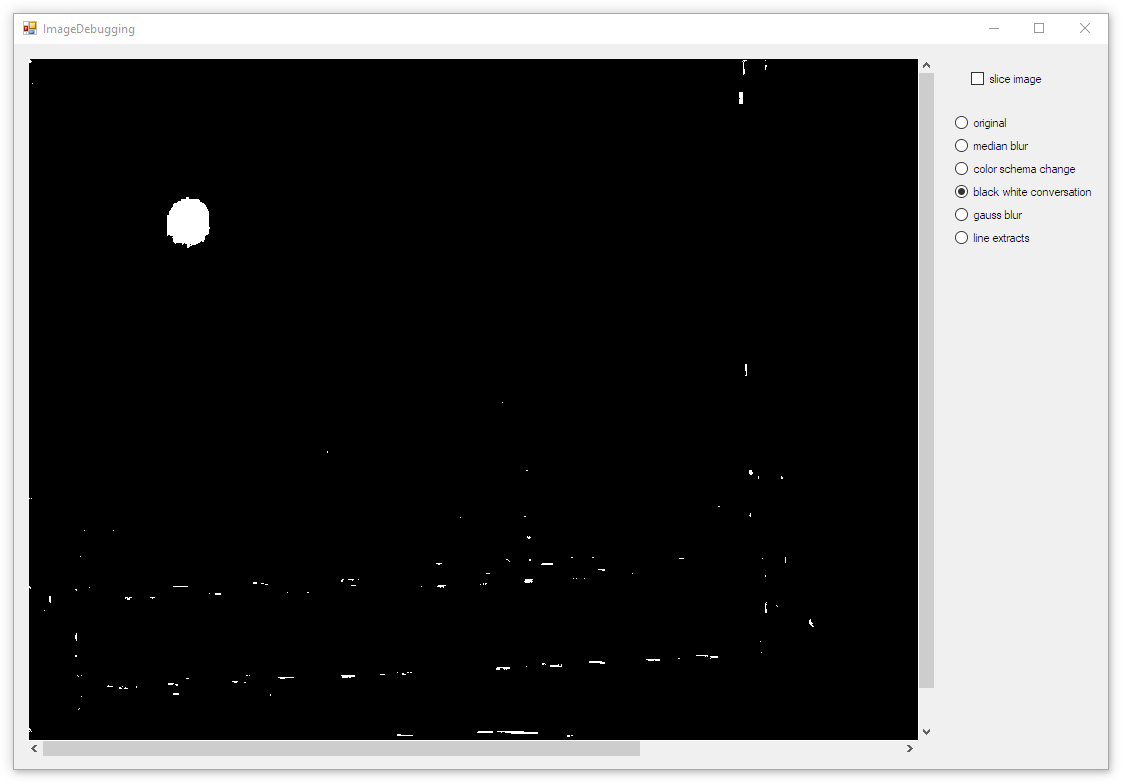
VortragsMedien/Images/ImageDebuggingWindow/BlackWhite.png
