R-Studios/Rocky-Hockey-IV/VortragsMedien/Images/ImageDebuggingWindow/BlackWhite_Sliced.png

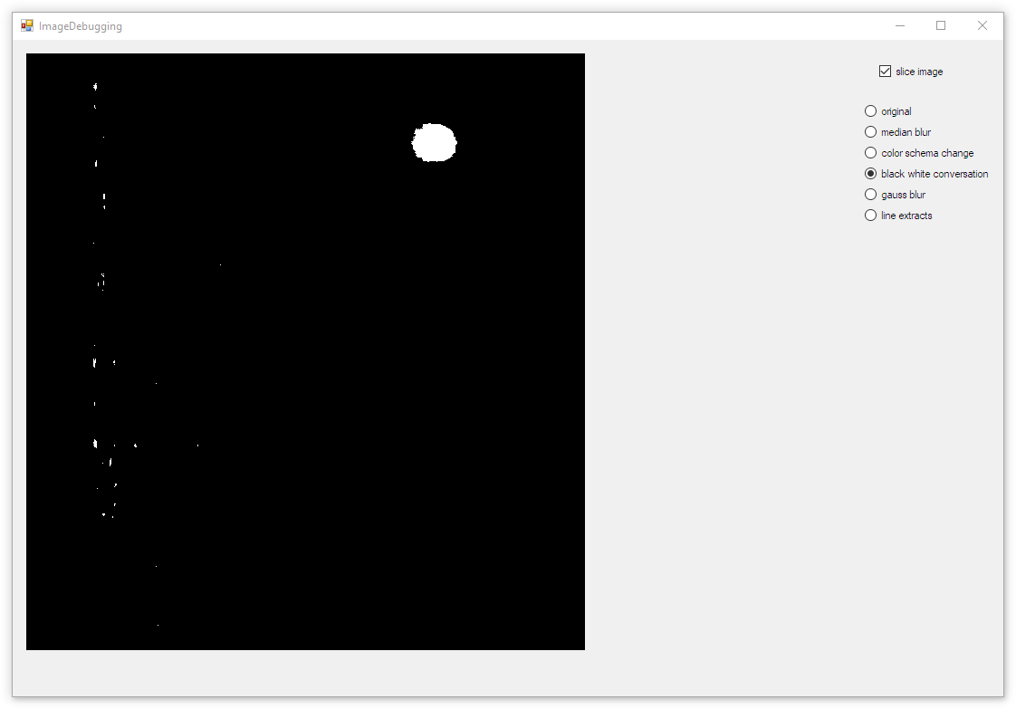
VortragsMedien/Images/ImageDebuggingWindow/BlackWhite_Sliced.png
