R-Studios/Rocky-Hockey-IV/VortragsMedien/Images/ImageDebuggingWindow/ChangedColorSchema_Sliced.png

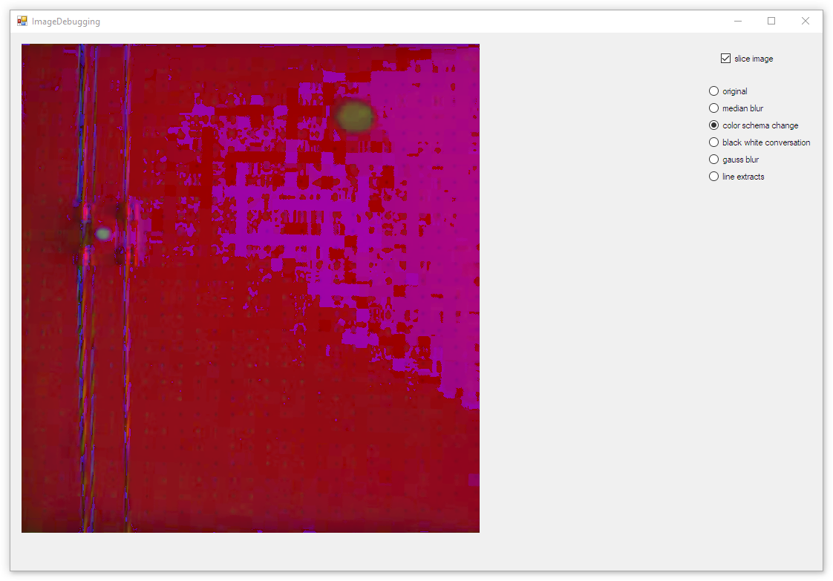
VortragsMedien/Images/ImageDebuggingWindow/ChangedColorSchema_Sliced.png
