R-Studios/Rocky-Hockey-IV/VortragsMedien/Images/ImageDebuggingWindow/MedianBlur_Sliced.png

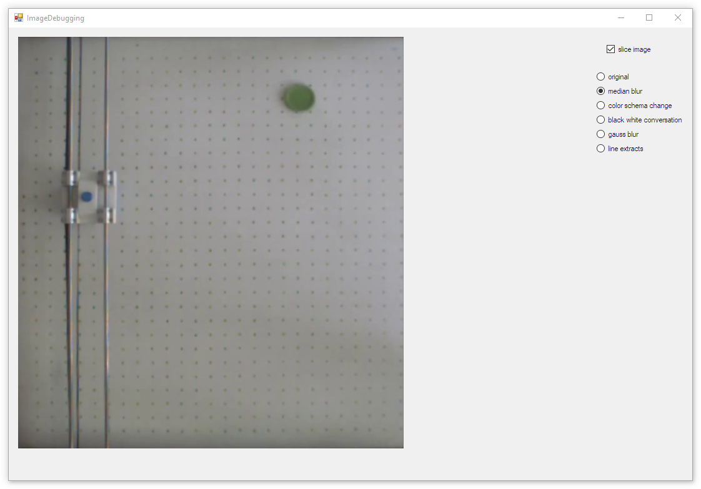
VortragsMedien/Images/ImageDebuggingWindow/MedianBlur_Sliced.png
