R-Studios/Rocky-Hockey-IV/Schaltplan/Schaltplan_neu.pdf

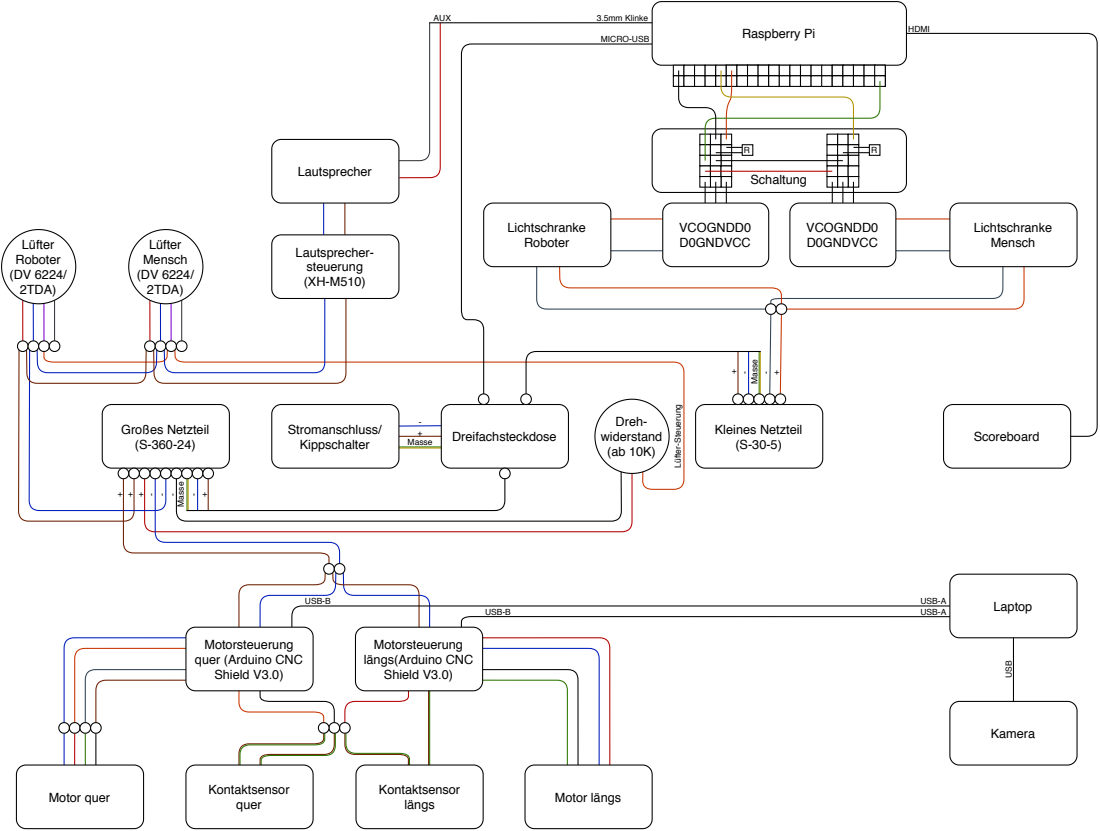
[picture p62: page 1]
Schaltung; - Masse; Masse; 3.5mm Klinke; USB-A; USB-B; MICRO-USB; Lüfter-Steuerung; Laptop; Kamera; HDMI; USB; Raspberry Pi; Kleines Netzteil (S-30-5); Lichtschranke Mensch; Lichtschranke Roboter; Stromanschluss/; Kippschalter; Dreifachsteckdose; Lüfter Mensch (DV 6224/ 2TDA); Lüfter Roboter (DV 6224/ 2TDA); Lautsprecher- steuerung (XH-M510); Lautsprecher; AUX; Dreh- widerstand (ab 10K); Großes Netzteil (S-360-24); Kontaktsensor quer; Kontaktsensor; längs Motor quer; Motor längs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

Motorsteuerung
quer (Arduino CNC
Shield V3.0)

längs(Arduino CNC
