R-Studios/Rocky-Hockey-IV/(commit log)

2020-04-05 Add files via upload
    Files des Pi-Ordners "Release"
2020-07-12 Add STL file folder
    [Hokey Seitenhalterung v3.f3d, Hokey Seitenhalterung v3.step, Hokey Seitenhalterung v3.stl, Puck v3.f3d, Puck v3.step, Puck v3.stl, Schraubenhalterung v3.f3d, Schraubenhalterung v3.step]
