R-Studios/Rocky-Hockey-IV/Rockey_HockeyFotos_31.03.2020/20200423_113429.jpg

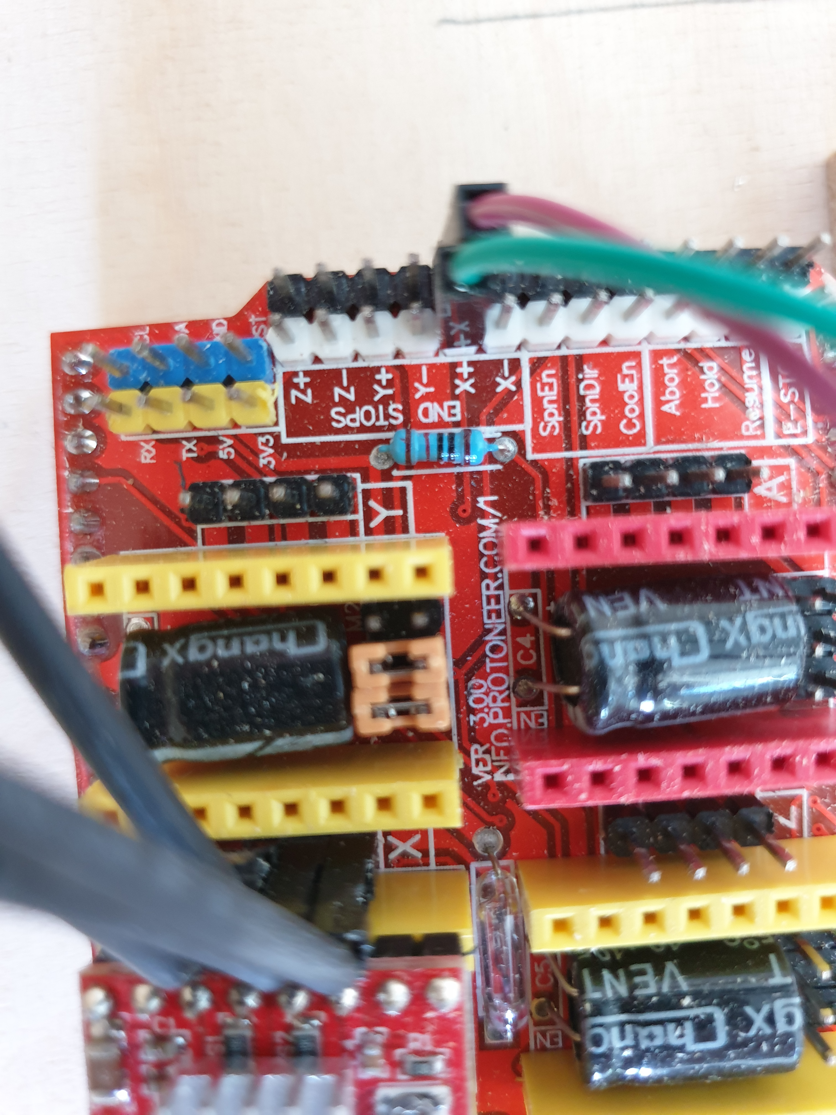
Rockey_HockeyFotos_31.03.2020/20200423_113429.jpg
