R-Studios/Rocky-Hockey-IV/Rockey_HockeyFotos_31.03.2020/20200619_112925.jpg

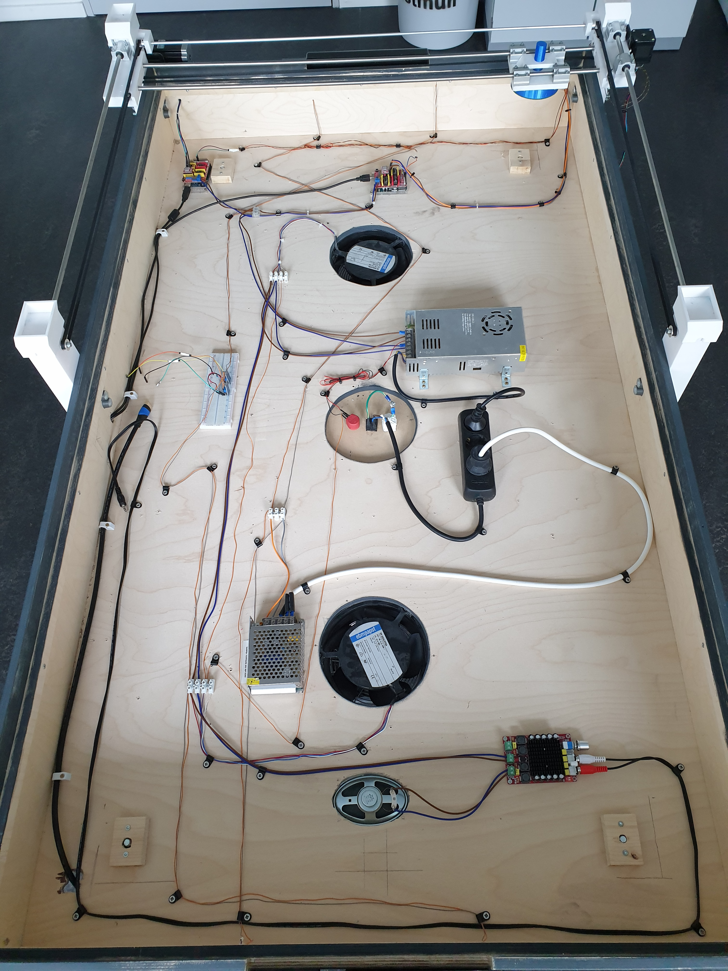
Rockey_HockeyFotos_31.03.2020/20200619_112925.jpg
